ElectronicCats/CatSniffer/hardware/README.md

# Hardware

- Schematic
- PCB Gerbers
- Hardware Libraries
