ElectronicCats/CatSniffer/ataques.md

# Ataques a protocolos IoT

## LoRa/LoRaWAN

- Bit flipping:

## BLE
- Handler enumeration
- List properties
- Flip boolean properties
- Fuzzing handler values

## Zigbee
- https://www.opencve.io/cve?vendor=mi&product=dgnwg03lm

## Thread
- 

## IEEE 802.15.4g,
-

### 6LoWPAN
-
