ElectronicCats/CatSniffer/workshops/BH USA 2023 Arsenal Lab - Catsniffer/BHUS23-Catsniffer.pptx

## Slide 2

Practical IoT Hacking: Introduction to Multi-Band Hacking with the CatSniffer

Eduardo Wero (@foreverwero) / Paulino Calderon (@calderpwn)

## Slide 3

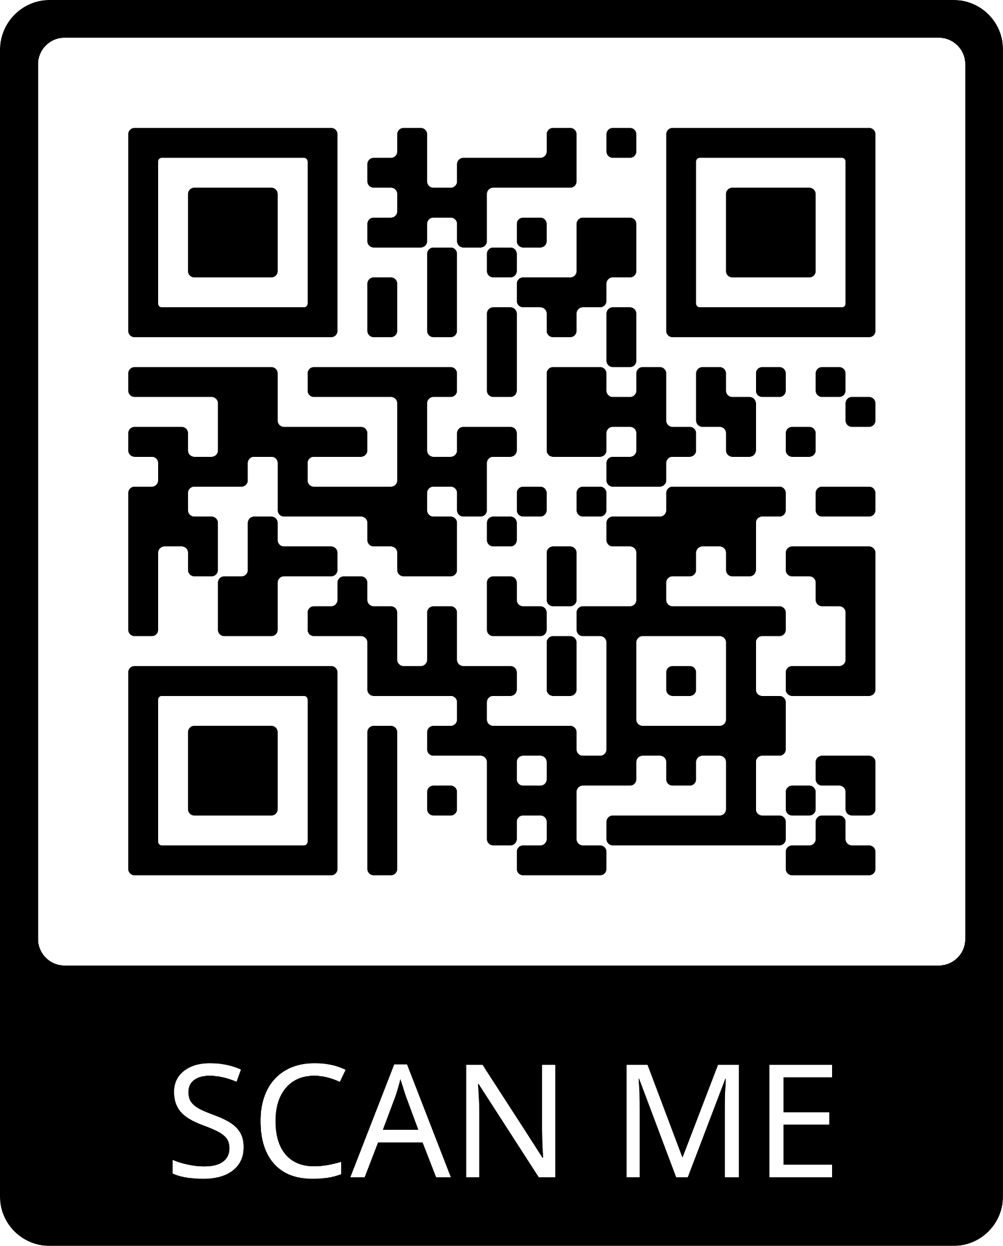
[picture p5: figure]

Workshop resources:

https://bit.ly/3Dsyqol

## Slide 4

CatSniffer

CatSniffer (😼) is an innovative, multi-protocol, multi-band open source circuit board made for sniffing, communicating, and attacking IoT (Internet of Things) devices. It was designed as a highly portable USB stick that integrates TI CC1352, Semtech SX1262, and Microchip SAMD21E17 (V1.x and V2.x)/RP2040 (V3.x).

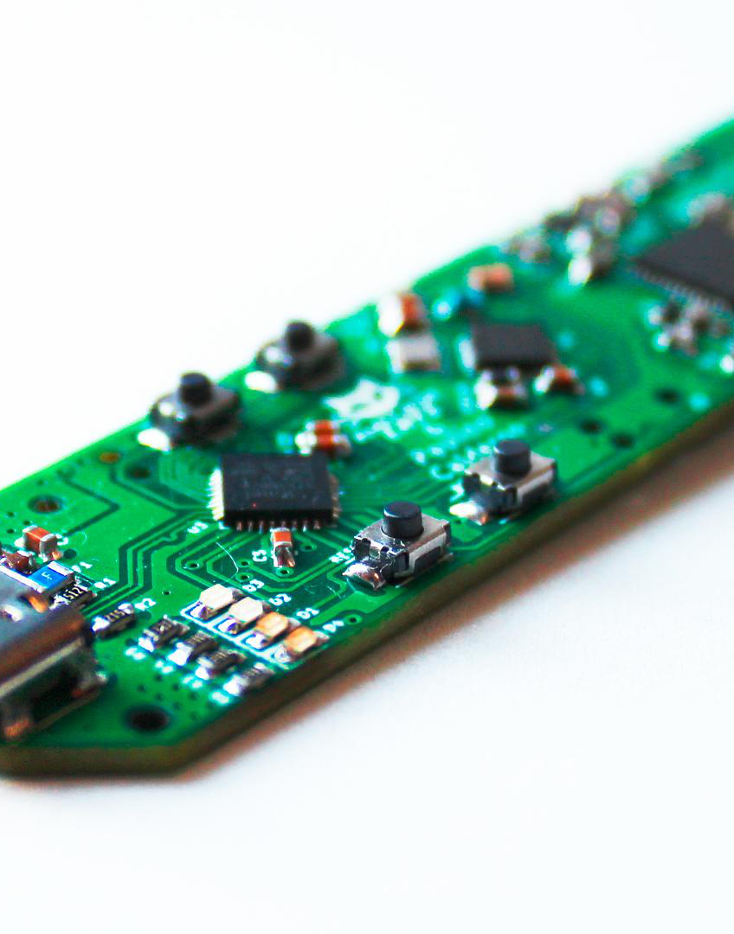
[picture p6: figure]

## Slide 5

## Slide 6

Supported software

This board is a Swiss army knife for IoT security researchers, developers, and enthusiasts. It's highly versatile, compatible with a wide array of software, including:
- Packet Sniffers (*)
- Security auditing tools
- Custom firmware developed by ElectronicCats/PWNLab
(*) It works in Windows with the latest Wireshark!

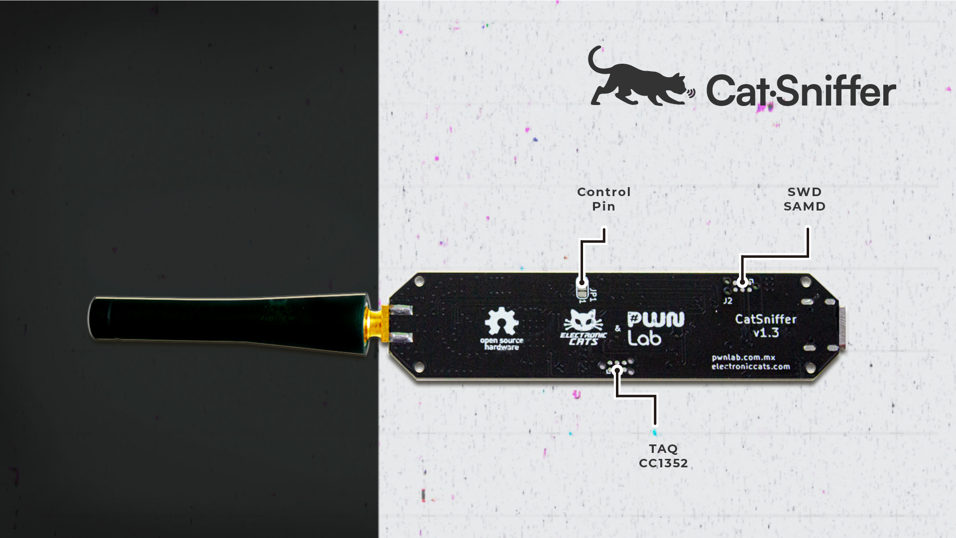
[picture p7: figure]

## Slide 7

Protocols

- Thread
- Zigbee
- Bluetooth 5 Low Energy (BLE)
- IEEE 802.15.4g
- 6LoWPAN (IPv6 over Low power Wireless Personal Area Networks)
- Sub 1Ghz and patented systems
- LoRa/LoRaWAN
Antenna support: 868/915 MHz up to 14 dBm, 2.4 GHz up to 20 dBm

1.x/2.x

- RP2040 microcontroller
- +Wi-SUN
- +Amazon Sidewalk
- +mioty®
Antena support: 433 MHz up to 13 dBm, 2.4 GHz up to 10 dBm

3.x

## Slide 8

SPI

Serial

SX1262

RF Switch

USB

RP2040

CC1352P7

JTAG

GPIOs

## Slide 9

Workshop prerequisites

To challenge yourself and follow along, you will need the following software (*):
- Workshop booklet
https://bit.ly/44yWQsj
- Code Composer Studio from https://www.ti.com/tool/CCSTUDIO
- Code sources from https://github.com/ElectronicCats/CatSniffer/
- Python3 (pyserial and other modules might be needed)
(*) It should be pre-installed in the Kali workstations but USBs with all the files should be available to copy the files to your machines!

## Slide 10

Flashing firmware from Linux

To program your Catsniffer with one of the firmwares available:
1. Locate the desired firmware. You will usually find official firmwares in .hex format.
https://github.com/ElectronicCats/CatSniffer/tree/master/firmware
1. Put the CatSniffer in upload mode for the CC1352P7, press reset for the RP2040 and the boot for the CC1352, then release the reset button and second the boot button, you shall see an animation on the LEDs in the CatSniffer, you are ready to upload the desire firmware to the CC1352.
2. Locate the utility cc2538-bsl.py found in the Code folder.
3. Install the requirements for cc2538-bsl.py by issuing the following commands:
$python3 -m pip install pyserial
$python3 -m pip install intelhex
1. Reset the RP2040 once you have flashed the CC1352P
2. If you would like to read serial information from a terminal, put back the CatSniffer in serial passthrough mode with the correct speed using Arduino IDE. (Optional)

## Slide 11

Practical examples

Follow along with booklet

## Slide 12

Hands on Lab #1: Sniffing BLE

## Slide 13

Learning objectives

1. Flash firmware for sniffing Bluetooth Low Energy connections
2. Basic usage of tools for analyzing BLE traffic
3. Packet structure of different types of BLE packets

## Slide 14

Hands on Lab #2: Detecting personal trackers

## Slide 15

Learning objectives

1. Learn about the technologies used in personal trackers
2. Learn how to detect personal trackers
3. Write custom firmware to detect personal trackers

## Slide 16

Hands on Lab #3: Spoofing personal trackers

## Slide 17

Learning objectives

1. Learn how to spoof personal trackers
2. Learn to craft custom BLE packets
3. Write firmware to communicate with devices over BLE

## Slide 18

Questions?

Eduardo Contreras (e@electroniccats.com)
Paulino Calderon (paulino@pwnlab.mx)
Catsniffer on Github
https://github.com/ElectronicCats/CatSniffer
Download this workshop: https://bit.ly/3Dsyqol
