ElectronicCats/CatSniffer/referencias.md

# Documentos o links de referencia

## Sniffers

- https://github.com/contiki-os/contiki/tree/master/examples/sensniff
- https://openthread.io/guides/pyspinel/sniffer
- https://github.com/andrewdodd/pyCCSniffer
- https://github.com/andrewdodd/ccsniffpiper
- https://github.com/mitshell/CC2531
- https://github.com/nccgroup/Sniffle
- https://hardwear.io/netherlands-2019/presentation/sniffle-talk-hardwear-io-nl-2019.pdf

## Zigbee
- https://github.com/Koenkk/zigbee2mqtt
- https://github.com/Koenkk/Z-Stack-firmware
- apimote http://apimote.com/
- APIMote Schematic https://github.com/riverloopsec/apimote

## Bootloader TI CC1352 

https://www.ti.com/lit/an/swra466c/swra466c.pdf

## CC1352 PINMAP
https://energia.nu/pinmaps/launchxl-cc1352/

## Flash con uniflash
- https://electrolama.com/projects/zig-a-zig-ah/#flashing-using-bsl
- https://github.com/JelmerT/cc2538-bsl
