ElectronicCats/CatSniffer/cases/case-catsniffer-text/front.png

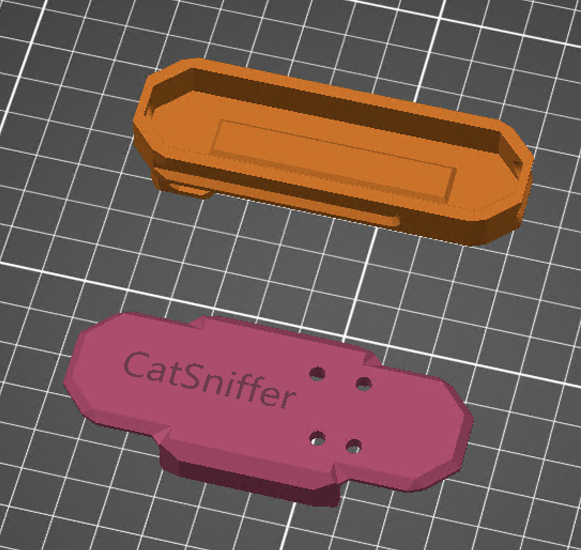
cases/case-catsniffer-text/front.png
