ElectronicCats/CatSniffer/cases/case-catsniffer-text/under.png

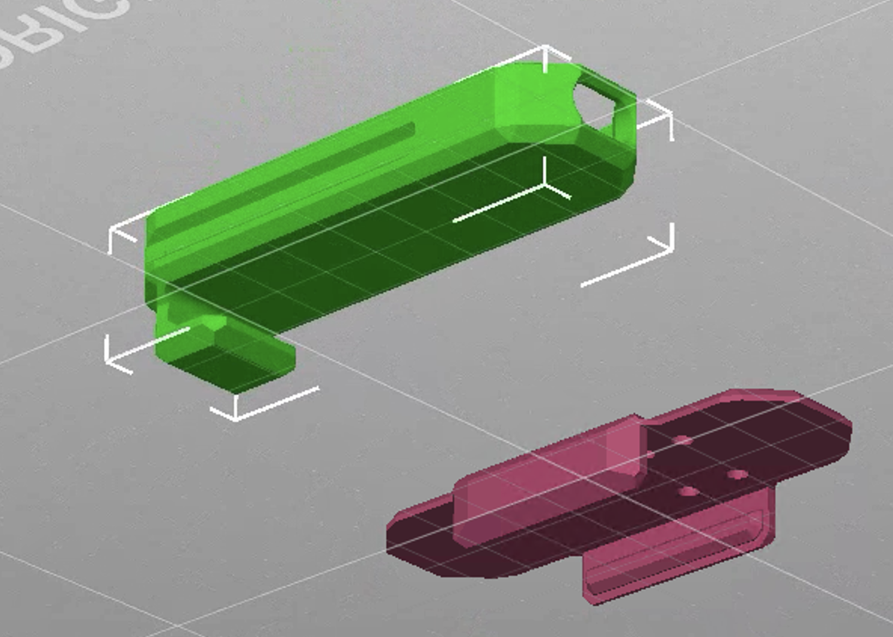
cases/case-catsniffer-text/under.png
