ElectronicCats/CatSniffer/cases/case-mamalon-v1/sc_case.jpg

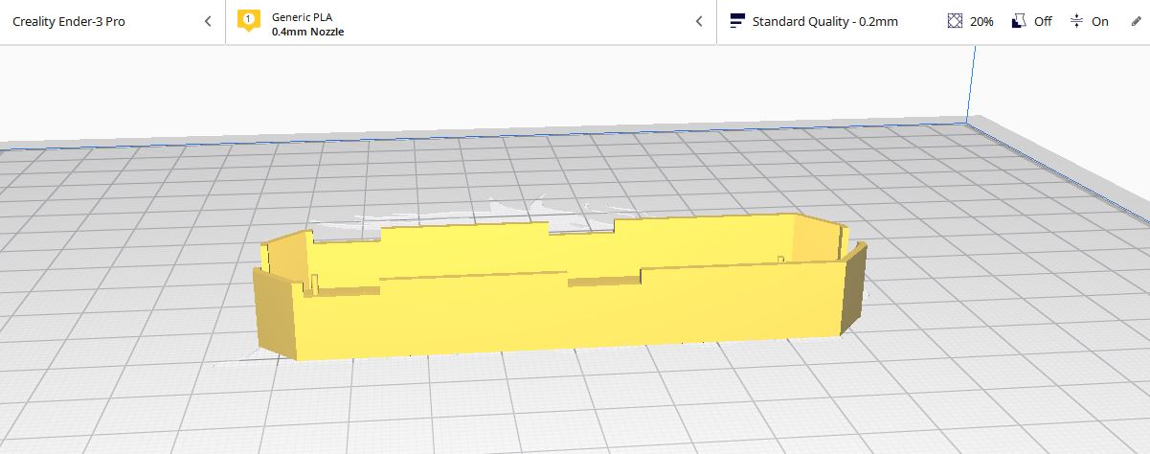
cases/case-mamalon-v1/sc_case.jpg
