ElectronicCats/CatSniffer/cases/case-mamalon-v1/sc_top.jpg

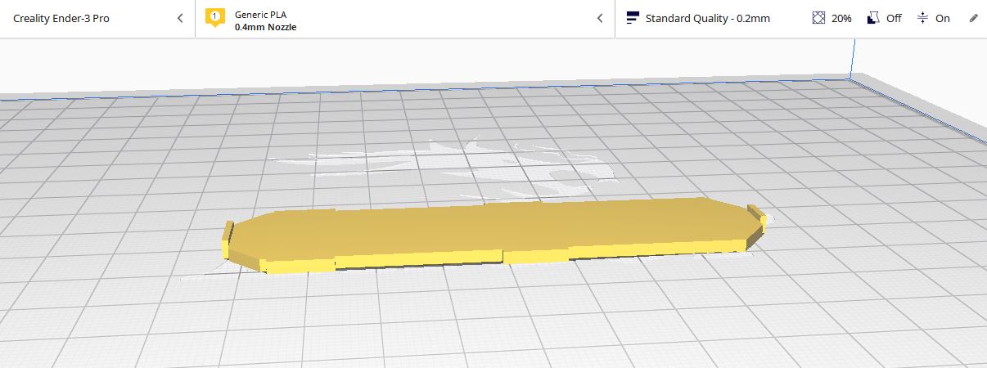
cases/case-mamalon-v1/sc_top.jpg
