ElectronicCats/CatSniffer/cases/basic-case/CatSniffer-case-top.stl

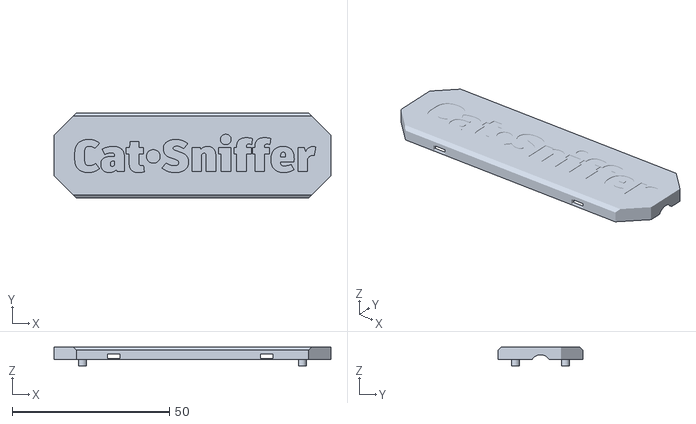
[picture p17: CAD file, 2021-08-19]
cases/basic-case/CatSniffer-case-top.stl
88.2 x 27.2 x 6.00
