ElectronicCats/CatSniffer/cases/case-catsniffer-text/Case-CatSniferText.3mf

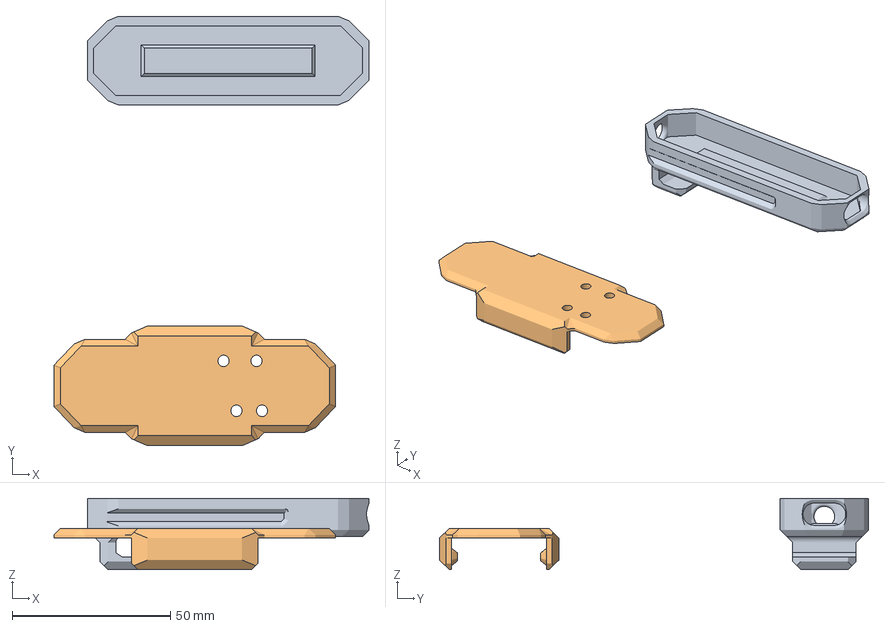
[picture p18: CAD file, 2024-06-25]
cases/case-catsniffer-text/Case-CatSniferText.3mf
99.6 x 135.7 x 22.5 mm
CatSnifer-Base.stl
CatSnifer-Tapa.stl
