ElectronicCats/CatSniffer/cases/case-mamalon-v1/sc_top.stl

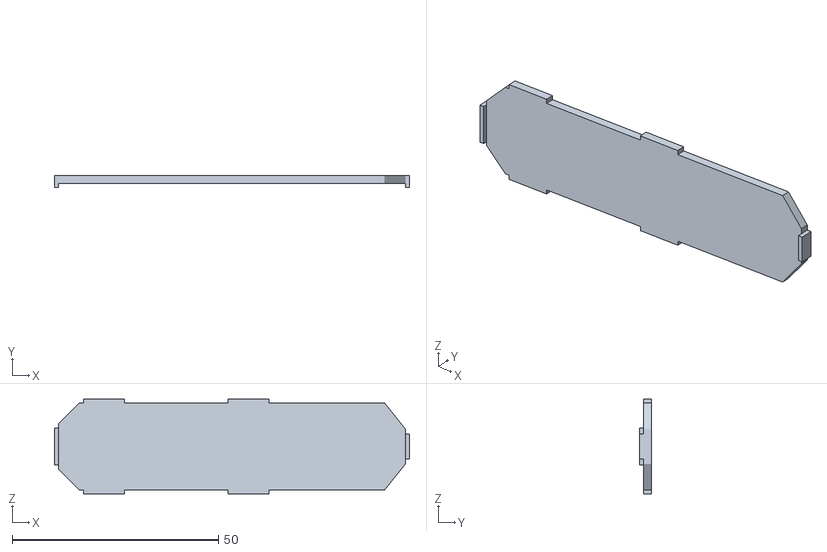
[picture p19: CAD file, 2021-09-11]
cases/case-mamalon-v1/sc_top.stl
86.0 x 3.00 x 23.0
