ElectronicCats/CatSniffer/cases/basic-case/CatSniffer-case-bottom.stl

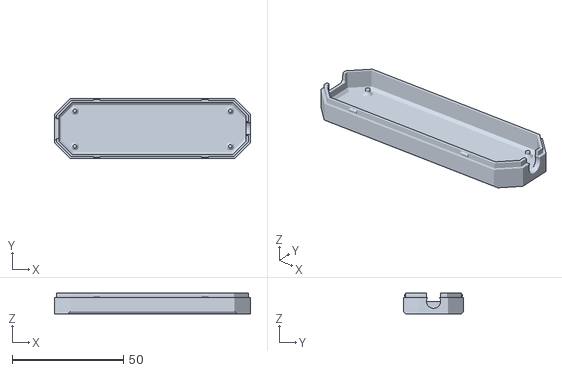
[picture p20: CAD file, 2021-08-19]
cases/basic-case/CatSniffer-case-bottom.stl
88.2 x 27.2 x 9.25
