ElectronicCats/CatSniffer/cases/case-mamalon-v1/sc_case.stl

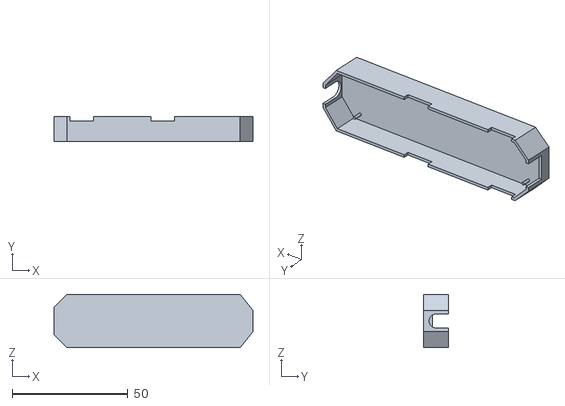
[picture p21: CAD file, 2021-09-11]
cases/case-mamalon-v1/sc_case.stl
86.0 x 11.0 x 23.0
