ElectronicCats/CatSniffer/cases/basic-case/CatSniffer-case.step

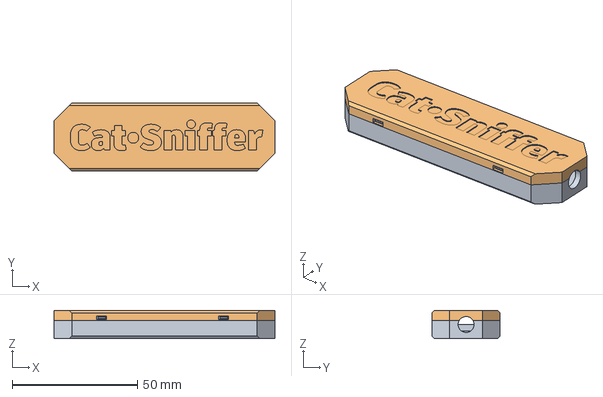
[picture p23: CAD file, 2021-08-19]
cases/basic-case/CatSniffer-case.step
88.2 x 27.2 x 11.2 mm
