ElectronicCats/CatSniffer/(threads)

Thread 18 (2022-01-07):

Wrong image path

Dioscelestial, 2022-01-07:
The part of wireshark.md can't show the images cause' don't have a properly image path in the files
The issues are in ElectronicCats/CatSniffer/docs/wireshark.md

cldrn, 2022-01-08:
Documentation is located at [https://github.com/ElectronicCats/CatSniffer/wiki](https://github.com/ElectronicCats/CatSniffer/wiki) for now. We will be generating an HTML document to include as offline documentation with the repository.

Closed 2022-01-08.

Thread 19 (2022-01-19):

Windows 11 Issue?

Cr0wTom, 2022-01-19:
Hello,

I am trying to setup the SmartRF Packet Sniffer 2 with catsniffer. I can see the serial device in the control panel, but the Device configuration button on SmartRF is grayed out and the device cannot be detected. I had the latest version, but now I am on 1.8.0 of smartRF. I tried many things (I also have the SDK installed) but nothing worked. Anyone solved this issue?

Thanks

wero1414, 2022-01-20:
Hi @Cr0wTom Did you select  the target device under the section of connected devices, to CC1352R?

This is mandatory so the SmartRF Flash Programmer 2 can be able to detect the UART bootloader

wero1414, 2022-01-20:
https://github.com/ElectronicCats/CatSniffer/wiki/assets/foto60.jpg

Arthulisher, 2022-01-20:
Hello Cr0wTom

Please follow the next tutorial:
(https://github.com/ElectronicCats/CatSniffer/wiki/06.-FAQ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)

Let us know any updates about your issue
Best regards...

Cr0wTom, 2022-01-24:
All good, fixed it with firmware reflash a couple of times :)

cldrn, 2022-01-25:
I am curious about what version did you use? Does this confirm Windows 11 support?

Cr0wTom, 2022-01-26:
Yes this confirms Windows 11 support.

I am using Windows 11 Pro (10.0.22000 Build 22000) and my hardware is v1.3.

cldrn, 2022-01-26:
Did you try 1.9 on win 11?

Closed 2022-02-21.

Thread 21 (2022-02-18):

Failed to flash a new firmware.

icabrera, 2022-02-18:
Hello,

I am trying to change the firmware of the CC1352.

I have succesfully loaded the sketch "Serial Passthrought with Bootloader" into the CatSniffer.

Also, I did the procedure to enter into bootloader by power off -- pressing boot button -- and then power on again. It didn't work and no LED activity.

I have noticed that CC1352 continues sending a message by UART (received by the serial passthorugh with boot) after it is supposed to be in a bootloader mode, so I think that CC1352 doesn't enter into bootloader.

The following is the received message, this is the same as when the Sniffer Firmware is working:

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

Note: I changed the baudrate in the bootloader sketch just to be sure that CC1352 is sending the same announcement, but also tried with 500000. Changed to 500000, the message is also arriving but it is not readable:

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

I have been trying since I received the CatSniffer but never been acomplished. I have tried with TI and Python tools but since CatSniffer is not in bootloader mode that tools doesn't work.

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

According to the CC13x2, CC26x2 SimpleLink Wireless MCU Technical Reference Manual, the baudrate of UART for bootloader can be synchoronized by sending 0x55 0x55.  The answer to this bytes, are the same, the announcement message.

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

The CatSniffer is working well with the stock firmware.

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

icabrera, 2022-02-21:
Yes, I tried both ways ( button and by sketch ), and also tried a mix of two, no success.

sabas1080, 2022-02-21:
@icabrera This product will be replaced under warranty.

defuzzlog, 2022-03-04:
Hi. I have the same situation. Catsniffer isn't recognised in the Smart RF Sniffer 1.9 (already checked FAQ wiki github page - still no result). When I try to change firmware of the 1352 - nothnig happens. I can upload Serial Passthrought with bootloader, but
Flash Programmer 2 doesn't see device and when I try to flash with python I get error " Timeout waiting for ACK/NACK after 'Synch (0x55 0x55)". Also when I try to enter bootloader through hardware  first pressing the “boot” button and while holding it, press and release "reset", and finally release the “boot” button - nothing happens, it didn't work and No LED activity.  Tried to run on three different computers, used different usb cables - nothing helps.

Closed 2022-02-21.

Thread 22 (2022-03-05):

Can't flash CC1352

defuzzlog, 2022-03-05:
Hi.
Catsniffer isn't recognized in the Smart RF Sniffer 1.9 (already read and applied advice from FAQ wiki GitHub page - still no result). When I try to flash the firmware of the 1352 - nothing happens. I can upload "Serial Passthrough with bootloader", but
Flash Programmer 2 doesn't see the device and when I try to flash with python I get the error " Timeout waiting for ACK/NACK after 'Synch (0x55 0x55)". Also when I try to enter the bootloader through hardware first press the “boot” button and while holding it, press and release "reset", and finally release the “boot” button - nothing happens, it didn't work and No LED activity. Tried to run on three different computers, used different USB cables - nothing helps.

defuzzlog, 2022-03-13:
Is there any other way I can help to solve this problem? Maybe some additional data or logs are needed? And should I hope for a solution to this problem? Thanks

sabas1080, 2022-03-13:
@defuzzlog CatSniffer is not compatible with version 1.9 of Smart RF Sniffer, you must use version 1.8 as indicated in our wiki.

when cat sniffer is in boot mode, there is no LED activity.

To ensure that the device is in boot mode press the BOOT button without connecting to the computer, keep the BOOT button pressed and then connect the device via USB, now release the BOOT button

defuzzlog, 2022-03-13:
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

Just checked in Smart RF Packet Sniffer 1.8 - it is doesn't detect Catsniffer.

Folowed you steps - press Boot and hold it until device connected via USB, release it after connection via usb. Doesn't help. It still can't find cc1352 over python cmd or flash programmer

defuzzlog, 2022-03-14:
> Hello @defuzzlog Could you share pictures of your COM port on the device manager? in order to see if your system is detecting your board.

Without catsniffer: [https://disk.yandex.ru/i/Fq3Yyq3xIx76dw](url)
With catsniffer: [https://disk.yandex.ru/i/Zy41JxDXJknXYQ](url)

Arthulisher, 2022-03-23:
Hello, @defuzzlog Could you describe or share a video of the Led 4 behavior when you plug the USB, Please? Also, could you upload to the cat sniffer the serial passthrough and describe the behavior too?

defuzzlog, 2022-03-29:
> Hello, @defuzzlog Could you describe or share a video of the Led 4 behavior when you plug the USB, Please? Also, could you upload to the cat sniffer the serial passthrough and describe the behavior too?

[https://youtu.be/QrYOePBE02g](url)

Arthulisher, 2022-03-29:
Hello @defuzzlog  thanks for the video, could you upload the SerialPassthrough.ino please and describe the behavior of LED D4, please?

Arthulisher, 2022-03-31:
Hello @defuzzlog

It seems to be that your CC1352 chips are bricked, could you send us an e-mail at the next address support2@electroniccats.com, please?
We are going to continue your issue by e-mail.

alphafox02, 2023-08-15:
Was this ever resolved, if so how was the CC1352 flashed?

Closed 2022-04-05.

Thread 25 (2022-06-26):

CC1352 and LoRa compatibility

reiniercoetzer, 2022-06-26:
Hi Electronic Cats (@Liars126) !

I recently came across your CatSniffer, which is a pretty handy device!

I am currently doing some research on LoRa compatible MCUs and officially it seems as though TI does not support LoRa. However, I also read that the CC1352 (which you guys are using) supports Amazon Sidewalk, which is based on LoRa (perhaps only the protocol?).

For the CatSniffer, I assume you use the Semtech SX1262 for LoRa, but since you are also familiar with the CC1352, do you perhaps know if this MCU is somehow compatible with the LoRa PHY?

Thanks in advance!

Best regards,
  Reinier

jazhe, 2022-07-01:
Hello @reiniercoetzer!

Thank you for the interest in our products and your feedback, is much appreciated!

Yes, we use Semtech SX1262 for LoRa and unfortunately CC1352 is not compatible with LoRa.

Thank you for you patience. Feel free to get back to us if you have any further queries.

Kind regards,
Electronic Cats Support Team

reiniercoetzer, 2022-07-07:
Many thanks for your feedback!

Maybe useful for someone else in the future (you guys know this of course):

I also got some information directly from TI and as expected the CC1352 PHY is not compatible with the standard LoRa modulation, i.e. LoRa uses chirp spread spectrum (CSS) technology, whereas the CC1352 PHY can do spread spectrum using GFSK, which is more applicable to Amazon Sidewalk for which the CC1352 is supported.

jazhe, 2022-07-07:
Hi @reiniercoetzer!

Thank you so much for your feedback, we appreciate it!

We are very grateful that you bring this to our attention. These types of feedback help us improve our platform and our products! Feel free to get back to us if you have any further queries or feedback.

Hope you have an amazing day!
Kind regards,
Electronic Cats Support Team

Closed 2022-07-06.

Thread 26 (2022-08-17):

Missing documentation

iamapentester, 2022-08-17:
This project is really hard to get started with.

The github contains a lot of firmwares and 3d Prints files but not really any informations of how to install the firmware and use the stick.

Could you make a quick-start guide - i am running Linux and bought this stick because it was linux compatible but have still not figured out how to get it up and running - wireshark plugins is only for windows :/

IvanAmg, 2022-08-17:
Hello @iamapentester!
Have you already visited our official Wiki?
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
There you'll find our quickstart guide.
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
Let me know if something else is missing!

iamapentester, 2022-08-18:
ah ! pages .. i missed them - thanks.

IvanAmg, 2022-08-18:
No worries at all!

Closed 2022-08-18.

Thread 27 (2022-08-22):

SmartRF can't detect CatSniffer

gilmarwsr, 2022-08-22:
SmartRF can't detect CatSniffer, is there any troubleshoot script? How can I check if the hardware (bought at DEFCON30) is fine?

I've tried some firmware scripts just to check the communication:
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

I've changed the timeout on the python script :

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

I'm switched from MacOS to an  Windows 8 on Parallels ... and the drivers seems to haven't been installed:
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

IvanAmg, 2022-08-23:
Hello @gilmarwsr !
May I ask if the LED4 is blinking when connected to your PC?
If so, please try to enter on bootloader mode.
To enter this mode, first press the “boot” button, and while holding it, press and release "reset", and finally release the “boot” button.
LED4 should now stop blinking.
Now you should be able to connect your board.
However, please let me know if the issue persists!

gilmarwsr, 2022-08-23:
> Hello @gilmarwsr !
> May I ask if the LED4 is blinking when connected to your PC?
Yes It is.

> If so, please try to enter on bootloader mode.
> To enter this mode, first press the “boot” button, and while holding it, press and release "reset", and finally release the “boot” button.
> LED4 should now stop blinking.
The LED4 stopped to blink so all LEDs are now off.

> Now you should be able to connect your board.
> However, please let me know if the issue persists!
Unfortunately the problem persists.

IvanAmg, 2022-08-24:
The CatSniffer has a similar chip as our DAPCat.
Please, try installing this driver https://zadig.akeo.ie/ if using windows 8.
And using MacOS, please specify your port when running the python script.
Let me know if the issue persists!

gilmarwsr, 2022-08-25:
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

I tried my best to install multiple drivers, change COM ports and etc... now, my CatSniffer LED4 is blinking and this two drivers are listed:
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

But, the SmartRF (v 1.8.0) still can't detect the CatSniffer...

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

IvanAmg, 2022-08-25:
Thanks a lot for all the information!
Let's try troubleshooting with the python script, as this is the easiest way to get more information about the issue.

First, please try to upload the SerialPassThroug with bootloader.ino as this guide says https://github.com/ElectronicCats/CatSniffer/wiki/02.-Flashing-firmwares-(Bootloader-Modes-and-Software)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,Bootloader%20mode%20through%20firmware,-To%20enter%20in

Then, try to enter bootloader mode.
To enter this mode, first press the “boot” button, and while holding it, press and release "reset", and finally release the “boot” button. LED4 should stop blinking by now.

After that, please, use the python cc2538-bsl.py -p "port" command on your terminal, where "port" is the port number of where the CatSniffer is connected to your PC, this may change depending on your OS.

Let me know if the issue persists!

gilmarwsr, 2022-08-26:
@IvanAmg

I've tried to upload via python:
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

I also tried via SmartRF Flash Programmer 2 (ver 1.8.2)

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

To be clear, in this SmartRF Flash section its an item (item 2)
> 2. Upload the firmware SerialPassThroughwithboot.ino to your CatSniffer.

I really don't understand if this is an instruction to me to upload the file to somewhere (how?) or this is what we gonna do now... (I'm Brazilian so English is not my first language).

IvanAmg, 2022-08-26:
@gilmarwsr In order to upload the SerialPassThroughwithboot.ino to your CatSniffer, you may need to use the Arduino IDE.
To install our board cores and support, please follow this part of the wiki.
https://github.com/ElectronicCats/CatSniffer/wiki/02.-Flashing-firmwares-(Bootloader-Modes-and-Software)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,Arduino%20IDE%20and%20Electronic%20Cats%20Board%20Support,-The%20Arduino%20Integrated
This .ino file is available right here.
https://github.com/ElectronicCats/CatSniffer/tree/master/firmware/SAMD/SerialPassthroughwithboot
Please, use the Arduino IDE to upload the SerialPassthroughwithboot.ino, and try to connect again with the python script.
Let me know if the issue persists!

gilmarwsr, 2022-08-26:
@IvanAmg
I've uploaded SerialPassThroughwithboot.ino

Sketch uses 9432 bytes (3%) of program storage space. Maximum is 262144 bytes.
Global variables use 2124 bytes of dynamic memory.
Atmel SMART device 0x10010094 found
Device       : ATSAMD21E17D
Chip ID      : 10010094
Version      : v1.1 [Arduino:XYZ] Jul 24 2021 11:48:53
Address      : 8192
Pages        : 1920
Page Size    : 64 bytes
Total Size   : 120KB
Planes       : 1
Lock Regions : 16
Locked       : none
Security     : false
Boot Flash   : true
BOD          : true
BOR          : true
Arduino      : FAST_CHIP_ERASE
Arduino      : FAST_MULTI_PAGE_WRITE
Arduino      : CAN_CHECKSUM_MEMORY_BUFFER
Erase flash
done in 0.577 seconds

Write 9784 bytes to flash (153 pages)
[==============================] 100% (153/153 pages)
done in 0.087 seconds

Verify 9784 bytes of flash with checksum.
Verify successful
done in 0.032 seconds
CPU reset.

But the python script ,or  SmartRF Flash Programmer 2, doesn't work.
Now, when I connect my board all LEDs are off, which I think its okay, right?
I can reset the CS1352P by press the reset button (and the LED4 starts to blink).
I've tried python script on boot settings (all LEDs off).

IvanAmg, 2022-08-29:
Hi! @gilmarwsr
Let's try a different thing.
On the [SerialPassthrough.ino](https://github.com/ElectronicCats/CatSniffer/blob/master/firmware/SAMD/SerialPassthrough/SerialPassthrough.ino) example, you'll see these baud rate code lines.
```
//unsigned long baud = 921600;//Baud for SmartRF Sniffer 2 also works with Smart RF Flash Programmer 2
unsigned long baud = 2000000;//Baud for Sniffle
//unsigned long baud = 115200;//Baud for Zigbee2MQTT
```
Please, comment the baud for sniffle and erase the // from Baud for SmartRF. Should look something like this.
```
unsigned long baud = 921600;//Baud for SmartRF Sniffer 2 also works with Smart RF Flash Programmer 2
//unsigned long baud = 2000000;//Baud for Sniffle
//unsigned long baud = 115200;//Baud for Zigbee2MQTT
```
Upload it to your board with Arduino IDE.
After that please, try to connect it again with SmartRF.
If the issue persists, please try the python script with your Mac OS pc, as the compatibility with Windows 8 is not fully tested yet.
Make sure that the command specifies the COM where you're connecting your CatSniffer to your Mac.

gilmarwsr, 2022-09-01:
@IvanAmg
Let me update the whole situation...
I was able to use the python script (only in MacOs), unfortunately, it seems to be a problem with windows 8 compatibility. I will try SmartRF as soon as possible with a fresh Windows 10 installation.
Is there any chances to use Wireshark on MacOS with CatSniffer?

IvanAmg, 2022-09-02:
@gilmarwsr
I'm glad that it is working now!
We'll include that compatibility issue in our wiki, thanks for letting us know about it.
There's a small guide about Wireshark using windows, it seems like Mac OS hasn't been tested yet, if you would like to try and share your results with us, that would be amazing!

Closed 2022-09-02.

Thread 46 (2023-08-15):

Feedback (CatSniffer v2)

alphafox02, 2023-08-15:
Received a CatSniffer over the weekend and wanted to share some notes while they're fresh.

Found my way to here after finding mention in another closed ticket
https://github.com/ElectronicCats/CatSniffer/wiki/02.-Flashing-firmwares-(CatSniffer-v1.x-and-2.x)

Attempted to get to bootloader mode on the CC1352 using the hardware method and 22.04, but after making double sure I was pushing the right button combo I always ended up getting back to one flashing light and the following (mentioned in another closed ticket)
```
Opening port /dev/ttyACM0, baud 500000
Connecting to target...
ERROR: Timeout waiting for ACK/NACK after 'Synch (0x55 0x55)'
```

I then grabbed the Arduino IDE and followed the software steps, uploaded the sketch that I finally found here (wiki doesn't say exactly where to find it)
https://github.com/ElectronicCats/CatSniffer/tree/master/firmware/V1.x_V2.x/SAMD21E17/SerialPassthroughwithboot

At which point I was able to perform the following, while not certain of the firmware version as it doesn't match what the wiki says

`python3 cc2538-bsl.py -e -w -v -p /dev/ttyACM0 /home/dragon/Downloads/CatSniffer/firmware/V1.x_V2.x/CC1352P2/TI_PACKET_SNIFFER/sniffer_fw/bin/cc1352p1lp/sniffer_fw.hex`

The one blue light blinks, but what I notice is that after unplugging and plugging back in no lights blink and it's essentially needing me to reflash the hex file.

pycatsniffer.py seems to run, but there's no results.

Is there a newer/more clear set of steps to follow when going from brand new to operation? There was one light blinking on it when I took it out of the bag, but pycatsniffer.py did not seem to work and would just hang. Surely I'm missing something here.

alphafox02, 2023-08-15:
Most likely now a mistake on my part, but I tried the cc1352r1lp/sniffer_fw.hex file to see if there was a difference and now I'm unable to reflash anything even after uploading the sketch.

Eric286, 2023-08-15:
Hello @alphafox02 !

Sorry to hear you're having trouble with your CatSniffer. In order to help you more effectively, I would need a few additional details.

Firstly, could you share a photograph of both sides of the catSniffer please, to verify the version you have.

What operating system are you using? For example, Windows, macOS, or Linux.

You mentioned that some lights blink at certain times, while at other times they don't. Could you describe in detail what the status of the lights is at different times (at power on, when trying to load firmware, etc.)?

Any error messages you may have received, such as the one you mentioned: "ERROR: Timeout waiting for ACK/NACK after 'Synch (0x55 0x55)'". These details will help us better understand the problem.

I also saw that you sent us an email, please let me know if you would like to receive support via Github or if you prefer to receive support via email.

Have a good day!

alphafox02, 2023-08-16:
I can send pics via email if you reach out and follow up as needed (it states v2.0 on both sides), thought maybe details here will help someone else.

I'm using Linux, 22.04 to be specific. When I very first received the device there was the one light blinking when plugged in, however as I mentioned above the pycatsniffer did not function properly.

So I attempted to follow the wiki, the button combo to get into bootloader mode would not work for me. I had to move to the other method, which worked. I was able to load the cc1352p1lp/sniffer_fw.hex file. Unplugging and plugging the catsniffer back in would result in the one light blinking and the pycatsniffer would at least not freeze up when starting/stopping and existing but I still seemed to get no results.

So I ended up flashing the other firmware against my better judgement, cc1352r1lp/sniffer_fw.hex.

Now when i unplug and plug back in the sniffer no lights are lit at all. If I run through uploading the sketch a file links blink on it until it's done, at which point no lights are blinking. It's like it's in bootloader mode, but it's locked or something as I can no longer flash a .hex file without it ending in the ACK/NACK error. That's the only error I have.

Before flashing with the cc135r1lp hex file I could put it in bootloader mode over and over without issue and reflash the cc1352p1lp as many times as I wanted.

Eric286, 2023-08-16:
Hello @alphafox02

Thank you for the information and yes please send me the photographs by mail.

Also to unbrick the CC135, you would have to follow these steps.

In order to restore the CC1352 firmware from brick, you'll need a J-Link or any similar programmer.
This guide will explain how to recover from a brick state using a J-Link programmer.

Download and install J-link software: https://www.segger.com/downloads/jlink/
Connect your CatSniffer using the correct connector. If the JTAG connector is not available, using jumper cables may be a solution.
Make sure that each pin is connected properly with the SWD pinout (programmer and CatSniffer).
Open J-Flash Lite.
Download the firmware file: https://github.com/ElectronicCats/CatSniffer/tree/master/firmware/TI_PACKET_SNIFFER/sniffer_fw/bin

IMPORTANT
Make sure which chip your CatSniffer includes.
The steps shown in this guide explain how to restore a CC1352P1F3 chip.
Select this chip on J-Link Software, and upload the corresponding .hex file.
Finally, press the Program Device button.
The LED 4 blink will tell you if the programming was successful.

Kind Regards!

alphafox02, 2023-08-16:
Looking at the cost on some of these J-Link programmers has me a little concerned. I’ll have to do some research there and see if some of the cheaper solutions do in fact work with the J Link Software.

Separately, you mention a guide and to connect to the correct pins. I went and had another look at the CatSniffer and there is no “pins” per se sticking up to attach you. Do you have a picture/guide somewhere that shows this type of connection setup?

Thank you.

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

Eric286, 2023-08-16:
Hello @alphafox02

There is also a cheaper option called the J-Link EDU

The pins are the ones below the label that says pwm lab.

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

In this section of the wiki, you can see more information and see how they connect to the j pins.

https://github.com/ElectronicCats/CatSniffer/wiki/08.-Restore-the-CC1352-firmware

You could use a Raspberry Pico if you wanted to and solder to the programming pins.

Kind Regards!

Support Team.

alphafox02, 2023-08-16:
Excellent and yes, I should’ve looked just a little further down on the wiki! I guess I wasn’t totally sure what was up, but now I’ll work on getting those items and it restored asap.

alphafox02, 2023-08-18:
Thank you. I’ve put an order in for parts to get it back up and going. I’ll follow up once complete.

Eric286, 2023-08-18:
Hello @alphafox02

If you'd like, we can close the GitHub issue for now, and when you have the parts, we can reopen it. Alternatively, if you prefer, we can keep the GitHub issue open.

Kind Regards!

Support Team.

alphafox02, 2023-08-25:
Word of advice for anyone having a similar issue. The J-Link EDU mini and the TC2030 plug of nails cable are not going together by default. The mini is tiny and has pins far closer together than the TC2030 connector. I couldn’t tell how small the mini was till it arrived.

Eric286, 2023-08-25:
Hello @alphafox02

Eric286, 2023-08-25:
Hello @alphafox02

Thank you for sharing the word of advice about the compatibility between the J-Link EDU mini and the TC2030 plug of nails cable. Your input will certainly be valuable to others who might face a similar issue.

If you encounter any further difficulties or wish to share any feedback, please feel free to reach out to us again. We are here to assist you.
Wishing you a fantastic day ahead!

Kind regards,

Electronic Cats Support Team.

alphafox02, 2023-08-26:
Reading over this link here is basically where I'm at too. I've purchased the programmer, cable, and went and found a 10 pin to six pin. I've followed the steps listed on the wiki in section 8, have the software downloaded and can run the J-Flash Lite but with cjtag settings I can see one light flash when hitting erase and program on the GUI.. but it always says also Error could not connect to target.

I don't know if I want to invest more time/money into getting this back working. Seems like a nice device though.

Eric286, 2023-08-29:
Hello @alphafox02

Could you send me a video of the process in addition to the invoice of your purchase to this email please.

support4@electroniccats.org

Best regards!

alphafox02, 2023-08-30:
Soon as I get home I sure will. I’ll close this out and contact via email. I think if we get it flashed back and working I’ll just come back and update this with the details.

alphafox02, 2023-10-02:
Package arrived today! Got it plugged in and haven’t had a lot of time to test but I did try the default python script provided and attempted into Wireshark. I see a lot of output python side but nothing Wireshark side yet. I’ll test with known ble tx asap.Thank you very much for all the help! I can’t wait to make some videos on its usage. Sent from my iPhoneOn Aug 29, 2023, at 4:03 PM, Eric Chavez ***@***.***> wrote:
Hello @alphafox02
Could you send me a video of the process in addition to the invoice of your purchase to this email please.
***@***.***
Best regards!

—Reply to this email directly, view it on GitHub, or unsubscribe.You are receiving this because you were mentioned.Message ID: ***@***.***>

alphafox02, 2023-10-03:
Also tried to flash the sniffle binary via uniflash and python script but it’s unclear if I need to put it into bootloader mode. I tried with holding reset 1 and boot 1 and releasing reset 1. But only blue light comes back on and flashes, nothing else.How are you all loading the .our file for 1.6 sniffle on the v.3.x CatSniffer? It seems that currently in Linux only snuffle and potentially the ble info into Wireshark may work? Sent from my iPhoneOn Oct 2, 2023, at 7:05 PM, Alpha Fox ***@***.***> wrote: Package arrived today! Got it plugged in and haven’t had a lot of time to test but I did try the default python script provided and attempted into Wireshark. I see a lot of output python side but nothing Wireshark side yet. I’ll test with known ble tx asap.Thank you very much for all the help! I can’t wait to make some videos on its usage. <image0.jpeg>Sent from my iPhoneOn Aug 29, 2023, at 4:03 PM, Eric Chavez ***@***.***> wrote:
Hello @alphafox02
Could you send me a video of the process in addition to the invoice of your purchase to this email please.
***@***.***
Best regards!

—Reply to this email directly, view it on GitHub, or unsubscribe.You are receiving this because you were mentioned.Message ID: ***@***.***>

Eric286, 2023-10-03:
Hello @alphafox02

Please first upload the uf2 file called SerialPassthroughwithboot.

https://github.com/ElectronicCats/CatSniffer/tree/master/firmware/V3.x/RP2040/SerialPassthroughwithboot

Press the reset button twice and drag the uf2 file to the file explorer.

After uploading the file, reset the board.

Then put the CC1352 in bootloader mode.
    Press and hold the "reset_CC1" button.
    While still holding the "reset_CC1" button, press and hold the "BOOT1" button.
    Release the "reset_CC1" button first.
    Release the "BOOT1" button.

After this please try the python steps again.

Have a nice day!

Support Team.

alphafox02, 2023-10-04:
Tried as I believe you’re describing, assuming you mean to run and attempt to install sniffle after in bootloader mode. See picture. What I’m also not understanding is what is the tool pyCatSniffer designed for? Is there anything linux related that can run with the CatSniffer in the state it’s delivered in?Sent from my iPhoneOn Oct 3, 2023, at 12:15 PM, Eric Chavez ***@***.***> wrote:
Hello @alphafox02
Please first upload the uf2 file called SerialPassthroughwithboot.
https://github.com/ElectronicCats/CatSniffer/tree/master/firmware/V3.x/RP2040/SerialPassthroughwithboot
Press the reset button twice and drag the uf2 file to the file explorer.
After uploading the file, reset the board.
Then put the CC1352 in bootloader mode.
Press and hold the "reset_CC1" button.
While still holding the "reset_CC1" button, press and hold the "BOOT1" button.
Release the "reset_CC1" button first.
Release the "BOOT1" button.
After this please try the python steps again.
Have a nice day!
Support Team.

—Reply to this email directly, view it on GitHub, or unsubscribe.You are receiving this because you were mentioned.Message ID: ***@***.***>

alphafox02, 2023-10-04:
I also tried the following, never finishes and when I unplug and plug back in the CatSniffer it’s flashing two blue lights Sent from my iPhoneOn Oct 3, 2023, at 8:39 PM, Alpha Fox ***@***.***> wrote: Tried as I believe you’re describing, assuming you mean to run and attempt to install sniffle after in bootloader mode. See picture. What I’m also not understanding is what is the tool pyCatSniffer designed for? Is there anything linux related that can run with the CatSniffer in the state it’s delivered in?<image0.jpeg>Sent from my iPhoneOn Oct 3, 2023, at 12:15 PM, Eric Chavez ***@***.***> wrote:
Hello @alphafox02
Please first upload the uf2 file called SerialPassthroughwithboot.
https://github.com/ElectronicCats/CatSniffer/tree/master/firmware/V3.x/RP2040/SerialPassthroughwithboot
Press the reset button twice and drag the uf2 file to the file explorer.
After uploading the file, reset the board.
Then put the CC1352 in bootloader mode.
Press and hold the "reset_CC1" button.
While still holding the "reset_CC1" button, press and hold the "BOOT1" button.
Release the "reset_CC1" button first.
Release the "BOOT1" button.
After this please try the python steps again.
Have a nice day!
Support Team.

—Reply to this email directly, view it on GitHub, or unsubscribe.You are receiving this because you were mentioned.Message ID: ***@***.***>

alphafox02, 2023-10-04:
Well in this case I was using the wrong directory/firmware.. I’ll try again with v3 Sent from my iPhoneOn Oct 3, 2023, at 8:46 PM, Alpha Fox ***@***.***> wrote: I also tried the following, never finishes and when I unplug and plug back in the CatSniffer it’s flashing two blue lights <image0.jpeg>Sent from my iPhoneOn Oct 3, 2023, at 8:39 PM, Alpha Fox ***@***.***> wrote: Tried as I believe you’re describing, assuming you mean to run and attempt to install sniffle after in bootloader mode. See picture. What I’m also not understanding is what is the tool pyCatSniffer designed for? Is there anything linux related that can run with the CatSniffer in the state it’s delivered in?<image0.jpeg>Sent from my iPhoneOn Oct 3, 2023, at 12:15 PM, Eric Chavez ***@***.***> wrote:
Hello @alphafox02
Please first upload the uf2 file called SerialPassthroughwithboot.
https://github.com/ElectronicCats/CatSniffer/tree/master/firmware/V3.x/RP2040/SerialPassthroughwithboot
Press the reset button twice and drag the uf2 file to the file explorer.
After uploading the file, reset the board.
Then put the CC1352 in bootloader mode.
Press and hold the "reset_CC1" button.
While still holding the "reset_CC1" button, press and hold the "BOOT1" button.
Release the "reset_CC1" button first.
Release the "BOOT1" button.
After this please try the python steps again.
Have a nice day!
Support Team.

—Reply to this email directly, view it on GitHub, or unsubscribe.You are receiving this because you were mentioned.Message ID: ***@***.***>

alphafox02, 2023-10-04:
I made a small video and have tried several ways so far. Always ends in Synch (0x55 0x55) and each time I plug in CatSniffer it’ll have the outer two blue lights flashing in sync as if it’s just waiting for me to run the method to put it in  bootloader mode. CatSniffer - Google Drivedrive.google.comSent from my iPhoneOn Oct 3, 2023, at 8:39 PM, Alpha Fox ***@***.***> wrote: Tried as I believe you’re describing, assuming you mean to run and attempt to install sniffle after in bootloader mode. See picture. What I’m also not understanding is what is the tool pyCatSniffer designed for? Is there anything linux related that can run with the CatSniffer in the state it’s delivered in?<image0.jpeg>Sent from my iPhoneOn Oct 3, 2023, at 12:15 PM, Eric Chavez ***@***.***> wrote:
Hello @alphafox02
Please first upload the uf2 file called SerialPassthroughwithboot.
https://github.com/ElectronicCats/CatSniffer/tree/master/firmware/V3.x/RP2040/SerialPassthroughwithboot
Press the reset button twice and drag the uf2 file to the file explorer.
After uploading the file, reset the board.
Then put the CC1352 in bootloader mode.
Press and hold the "reset_CC1" button.
While still holding the "reset_CC1" button, press and hold the "BOOT1" button.
Release the "reset_CC1" button first.
Release the "BOOT1" button.
After this please try the python steps again.
Have a nice day!
Support Team.

—Reply to this email directly, view it on GitHub, or unsubscribe.You are receiving this because you were mentioned.Message ID: ***@***.***>

Eric286, 2023-10-04:
Hello @alphafox02.

Please follow these steps to restore the Catsniffer, then follow the steps I mentioned above, this resolves the error 0x55 0x55

https://github.com/ElectronicCats/CatSniffer/wiki/08.-Restore-the-CC1352-firmware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

Best Regards!

alphafox02, 2023-10-12:
Just noticing this, I'm slightly confused with the directions as it looks
like I'd need to set up windows and follow all steps, not sure the rp2040.
However, I think my catsniffer is probably fine because I do not think I
ever got into boot mode to begin with to have changed the firmware at all.

If you still suggest I follow the guide above I can find a windows
computer, but my time may be better spent trying to do a video call as soon
as possible.

On Wed, Oct 4, 2023 at 11:49 AM Eric Chavez ***@***.***>
wrote:

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

alphafox02, 2023-10-12:
Eric,Against my better judgement again haha I followed the guide you pointed me to the T using a windows computer. All seemed to be going well till the part where I tried to erase sector and you’ll see the issue attached. Now the CatSniffer is back to a state where there’s no flashing lights when plugged in and trying to run through the above with openocd and telnet ends with same result Sent from my iPhoneOn Oct 11, 2023, at 9:35 PM, Alpha Fox ***@***.***> wrote: Just noticing this, I'm slightly confused with the directions as it looks like I'd need to set up windows and follow all steps, not sure the rp2040. However, I think my catsniffer is probably fine because I do not think I ever got into boot mode to begin with to have changed the firmware at all.If you still suggest I follow the guide above I can find a windows computer, but my time may be better spent trying to do a video call as soon as possible. On Wed, Oct 4, 2023 at 11:49 AM Eric Chavez ***@***.***> wrote:
Hello @alphafox02.
Please follow these steps to restore the Catsniffer, then follow the steps I mentioned above, this resolves the error 0x55 0x55
https://github.com/ElectronicCats/CatSniffer/wiki/08.-Restore-the-CC1352-firmware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
Best Regards!

—Reply to this email directly, view it on GitHub, or unsubscribe.You are receiving this because you were mentioned.Message ID: ***@***.***>

alphafox02, 2023-10-12:
Rp2040 is also no longer reachable by double clicking the button. Sent from my iPhoneOn Oct 4, 2023, at 11:49 AM, Eric Chavez ***@***.***> wrote:
Hello @alphafox02.
Please follow these steps to restore the Catsniffer, then follow the steps I mentioned above, this resolves the error 0x55 0x55
https://github.com/ElectronicCats/CatSniffer/wiki/08.-Restore-the-CC1352-firmware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
Best Regards!

—Reply to this email directly, view it on GitHub, or unsubscribe.You are receiving this because you were mentioned.Message ID: ***@***.***>

alphafox02, 2023-10-18:
“ You must copy the.uf2 file to the device and set it in Boot mode before you may load the file by hitting SW1.”This may have been the only area of confusion. I copied the file to the rp2040, but why is this sentence saying then set to boot mode before to may load the file? Which file? I would’ve already copied the file like it says in the first line and it seems to load it itself. When I got to the telnet part and ran the commands that’s where it failed to provide the expected result. Now all I’m able to do is plug back in the CatSniffer to a windows computer. It has no lights on, and run OpenOCD. But then all im able to do is telnet and so I have no way of reaching the rp2040. Sent from my iPhoneOn Oct 18, 2023, at 8:53 AM, Alpha Fox ***@***.***> wrote: Following up. Any suggestions on how to recover the v3 since the steps I mentioned have led to where I’m at now? I’m willing to give it another chance, heck I may even just order another one because I do want to see it all work. Sent from my iPhoneOn Oct 11, 2023, at 10:48 PM, Alpha Fox ***@***.***> wrote: Eric,Against my better judgement again haha I followed the guide you pointed me to the T using a windows computer. All seemed to be going well till the part where I tried to erase sector and you’ll see the issue attached. Now the CatSniffer is back to a state where there’s no flashing lights when plugged in and trying to run through the above with openocd and telnet ends with same result <image0.jpeg>Sent from my iPhoneOn Oct 11, 2023, at 9:35 PM, Alpha Fox ***@***.***> wrote: Just noticing this, I'm slightly confused with the directions as it looks like I'd need to set up windows and follow all steps, not sure the rp2040. However, I think my catsniffer is probably fine because I do not think I ever got into boot mode to begin with to have changed the firmware at all.If you still suggest I follow the guide above I can find a windows computer, but my time may be better spent trying to do a video call as soon as possible. On Wed, Oct 4, 2023 at 11:49 AM Eric Chavez ***@***.***> wrote:
Hello @alphafox02.
Please follow these steps to restore the Catsniffer, then follow the steps I mentioned above, this resolves the error 0x55 0x55
https://github.com/ElectronicCats/CatSniffer/wiki/08.-Restore-the-CC1352-firmware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
Best Regards!

—Reply to this email directly, view it on GitHub, or unsubscribe.You are receiving this because you were mentioned.Message ID: ***@***.***>

Closed 2023-08-30.

Thread 47 (2023-08-29):

ElectronicCats - Bricked Card? Wrote incorrect version of firmware

Dlat, 2023-08-29:

YoshiDev22, 2023-08-31:
Hello Dlat,

Thank you for contacting us.

If you loaded a different firmware version, it can brick the board and it would be necessary to reprogram it with a J-Link, please try the process again or program it in another way, but if following the steps in our guide, it still can not load the correct firmware, a J-Link will be necessary.

Let us know your findings.
Kind regards,
Electronic Cats Support Team

Closed 2023-09-01.

Thread 48 (2023-09-03):

Flashing failed to verify, stuck.

lukeswitz, 2023-09-03:
Board v2.0 - Linux & Windows

Steps to flash
- Flash arduino serialtoboot
- Successfully got to step in python flash where it says to press reset after testing the port.
- Pressed reset, next command failed with the ACK/Synch error.
- Entered flash mode again manually with button combo
- Performed the command with the sniffer_fw.hex in the 1352r bin folder (the name in the docs doesn’t exist in the repo).
- Erased and flashed, verifying then ERROR timeout waiting after Get CRC32
- Led 2 now flashes whenever connected and it won’t go back into flash or boot mode.
- Holding boot and plugging it in causes all 4 leds to blink in succession.

Did I brick it already?

Marcelol52, 2023-09-04:
Hello Luke!

Thank you for contacting us!

I am sorry to hear you are having issues with you Cat Sniffer. To better understand your situation can you share the following information with us:

- What Operating System and version are you using? Linux distribution?
- Are you following this steps on windows or linux?
- Did the borad work before?
- Is it working/recognized in the Arduino IDE?
- Please connect your board and send me a screenshot of the Device Manager of the computer (with “Ports” open) if using Windows.
- Video of the behavior of the LEDs
- Photos of both sides of the board
- If you can, please share with us your invoice to this email address: support6@electroniccats.org

Kind regards,

Marcelo Arredondo
Electronic Cats

lukeswitz, 2023-09-04:
I flashed the original ino and it performs as when it arrived. So I think there's hope...

What Operating System and version are you using? Linux distribution?
- Debian & Windows 10

Are you following this steps on windows or linux?
- Tried linux, did not work, flashed the catsnifferLora back and it operated as it did when it arrived. I then switched to a windows environment to use the TI tools as outlined. With the `serialpassthough.ino` without boot and the baud set for the RF 2, I get it showing up and starting in Packet Sniffer2  v1.8 however it isn't seen in Wireshark and no data is captured by way of direct from Sniffer2.

Did the borad work before?
- Not sure.. it wasn't recognized as any type of device using Wireshark before attempting to flash. Same output when it arrived

Is it working/recognized in the Arduino IDE?
- Yes, it shows as a COM port in Windows and a dev/tty/ACM0 in linux

Please connect your board and send me a screenshot of the Device Manager of the computer (with “Ports” open) if using Windows
- These look exactly the same as in the closed issue, the board and the Ports, COM5 is how it's recognized.

Video of the behavior of the LEDs
- They go from 1 to 4 and repeat when the passthrough with boot and boot button held on poweron

Photos of both sides of the board
- Exactly as shown in closed issue of same, its the 2.0

If you can, please share with us your invoice to this email address: [support6@electroniccats.org](mailto:support6@electroniccats.org)
- Why?

Marcelol52, 2023-09-04:
Hi Luke,

Thanks for sharing the information with me.

I will try to replicate the issue you are expriencing on my end and update you as soon as I find a solution. Also, can you point me to where you raised your previous issue? We cannot find it in our closed issues for the Cat Sniffer.

Kind regards,

Marcelo Arredondo
Electronic Cats

lukeswitz, 2023-09-04:
Thanks! https://github.com/ElectronicCats/CatSniffer/issues/46#issuecomment-1681218535

Marcelol52, 2023-09-05:
Hi Luke,

One more question, what version of WireShark are you using?

Thanks and regards,

Marcelo Arredondo
Electronic Cats

lukeswitz, 2023-09-05:
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

Stable Release: 4.0.8

Marcelol52, 2023-09-05:
Hi Luke,

If you were following our tutorial to use TI's Packet Sniffer with Wire Shark, download satable version [3.0.14 of WireShark](https://2.na.dl.wireshark.org/win32/all-versions/). You will need to unisntall both programs before installing this version of WireShark or Packet Tracer might not detect WireShark.

Thanks and regards,

Marcelo Arredondo
Electronic Cats

lukeswitz, 2023-09-05:
I must have missed that- Thanks for all the help and quick replies. Loving all the toys from DEFCON. Keep being awesome.

lukeswitz, 2023-09-05:
While it did recognize Wireshark on Sniffer install the problem remains. Can you advise which .ino to flash? Putting it into boot loader mode with the ino or buttons leads to:
`ERROR: Timeout waiting for ACK/NACK after 'Get ChipID (0x28)' ` and when its not in bootloader mode:
`ERROR: Timeout waiting for ACK/NACK after 'Synch (0x55 0x55)'  ` is that anything you've encountered? Not able to flash using Ti flash either, just error.

Marcelol52, 2023-09-06:
Hi Luke,

I hope you are having a good day!

The fact that WireShark was detected by the Packet Sniffer is a good sign. You board's chip cc1352 already comes flashed from the factory, there is no need to change the firmware. To use your board with Packet Sniffer and Wire shark, you only need to flash [SerialPasstrough.ino](https://github.com/ElectronicCats/CatSniffer/tree/master/firmware/V3.x/RP2040/SerialPasstrough) to the RP2040 using the Arduino IDE. You can follow the steps shown [here](https://github.com/ElectronicCats/CatSniffer/wiki/04.-Supported-software#smartrf-packet-sniffer-2). Check that the board works like that. If later you need help flashing firmware to the cc1352 for another specific application we can check that together.

Kind regards,

Marcelo Arredondo
Electronic Cats

lukeswitz, 2023-09-06:
I wanted to flash your custom fw, but the tool does as above when using the ino you mention. Led 2 steady flash, nothing working in wireshark and sniffer can’t see the device. When serialpassthough.ino is uploaded it can communicate with rf sniffer but isn’t recognized by wireshark or log any packets in out modes.

Marcelol52, 2023-09-06:
Hi Luke,

When you downloaded Wire Shark, did you create the [Desktop Shortcut](https://github.com/ElectronicCats/CatSniffer/wiki/04.-Supported-software#smartrf-packet-sniffer-2-setup) with the requiered properties ("C:\<path>\Wireshark.exe" -i\\.\pipe\tiwspc_data -k)? This will set up the pipe from TI's Packet Sniffer to WireShark.

Kind regards,

Marcelo Arredondo
Electronic Cats

lukeswitz, 2023-09-06:
I did allow that on install, and it's plugins recognized in Wireshark. The issue I am concerned with is the inability to flash the CC chip after that first go I describe in first comment and subsequent errors in bootloader mode. Seems I borked the fw

Marcelol52, 2023-09-06:
Hi Like,

If you are able to use WireShark now with your board and see the sniffed packets, it means your board is working fine. Give me some time to try and flash the firmware you were trying to load and see if I get any similar errors or find a solution.

lukeswitz, 2023-09-06:
>does your board have? P or R?

Crap, it's a P and I flashed the R sniffer hex..

lukeswitz, 2023-09-06:
And I am not able to capture any traffic, likely because of the bad choice to flash that. Is there a way back from this without a physical programmer?

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

Marcelol52, 2023-09-07:
Hi Luke,

The only way right now to programm the board if it was bricked is using a J-link. We have a tutorial on our Wiki about this. I suggest you look into the J-link EDU, it is the most affordable one. The programmer might also be useful for your future projects. We are currently working on tutorials to reprogram bricked boards using Raspberry Pico or Raspberry PI, but they will come out some time in the future.

Can you share with me photos of both sides of your board?

lukeswitz, 2023-09-07:
That’s what I suspected. Nah I’m good. It’ll go in the dead bin for now. Thanks for the help. A thought though; don’t lead people directly to the bootloader on the readme- nobody sees the wiki unless you explicitly point it out seeing as there’s half a dozen bricked boards in these closed comments. The docs are good but jump back and forth between linux macOS and windows. Concise instructions on the readme.md would be beneficial.

It says it comes without firmware on the chip this is why I flashed it. And I imagine that’s why others did also.

Marcelol52, 2023-09-07:
Hi Luke,

Thanks for your feedback, we value our customer a lot and apreciate their input. We will take your advice into account for updating our docs. The best of luck on your future projects.

Kind regards.

cldrn, 2023-09-08:
Another option is to ship us the hardware or meet us at a security conference and we will re-flash it for you. We are usually at most major conferences in America. When will you attend your next CON?

lukeswitz, 2023-09-08:
> Another option is to ship us the hardware or meet us at a security conference and we will re-flash it for you. We are usually at most major conferences in America. When will you attend your next CON?

Not until next year. This is a very kind offer and I’d take you up on it. Are there any v3 boards available or in prod? I can email you if that’s better.

jazhe, 2023-09-08:
Hello @lukeswitz!
Please email us to support@electroniccats.com to start the process. Yes, we do have V3 boards available. We look forward to hearing from you.

lukeswitz, 2023-09-09:
Done and done and ✅

Marcelol52, 2023-10-06:
Hi Luke,

Just to let you know that we have received your old board (v2.0) and will send you the new (v3.1) one soon.

lukeswitz, 2023-10-06:
Thanks so much for all the support and service.

Closed 2023-09-07.

Thread 49 (2023-09-25):

ElectronicCats

fe8769a, 2023-09-25:
Hello I just received my catsniffer today . I have 40 years of computers stall knowledge and the same in radio reception.

I don't know how to begun

Under windows 10 , my catsniffer is recognize as com 3 but no led are lighting
I tried to push all buttons as described in documentation -- no chance

I have plenty of windows, linux , raspi computers all kind of versions

I installed the arduino IDE on a raspi 4 using dragon OS v31 (ubuntu) trying to communicate with catsniffer

I have error in running Arduino 1.8.19 like :+1:

Arduino: 1.8.19 (Linux), Board: "Arduino Uno"

/tmp/arduino_modified_sketch_710303/sketch_sep25a.ino: In function 'void setup()':
sketch_sep25a:68:3: error: 'Serial1' was not declared in this scope
   Serial1.begin(baud);
   ^~~~~~~
/tmp/arduino_modified_sketch_710303/sketch_sep25a.ino:68:3: note: suggested alternative: 'Serial'
   Serial1.begin(baud);
   ^~~~~~~
   Serial
/tmp/arduino_modified_sketch_710303/sketch_sep25a.ino: In function 'void loop()':
sketch_sep25a:91:5: error: 'Serial1' was not declared in this scope
     Serial1.write(Serial.read());   // read it and send it out Serial1 (pins 0 & 1)
     ^~~~~~~
/tmp/arduino_modified_sketch_710303/sketch_sep25a.ino:91:5: note: suggested alternative: 'Serial'
     Serial1.write(Serial.read());   // read it and send it out Serial1 (pins 0 & 1)
     ^~~~~~~
     Serial
sketch_sep25a:94:7: error: 'Serial1' was not declared in this scope
   if (Serial1.available()) {     // If anything comes in Serial1 (pins 0 & 1)
       ^~~~~~~
/tmp/arduino_modified_sketch_710303/sketch_sep25a.ino:94:7: note: suggested alternative: 'Serial'
   if (Serial1.available()) {     // If anything comes in Serial1 (pins 0 & 1)
       ^~~~~~~
       Serial
exit status 1
'Serial1' was not declared in this scope

This report would have more information with
"Show verbose output during compilation"
option enabled in File -> Preferences.

----------------------------------------------------------------------------
Can you explain the way to use catsniffer in windows 10 with TI packets sniffer

is there any different firmware for different applications ?

What is the exact way to start catsniffer

1- serial passthrough ? how ?
2- serial passthrough with bootloader ?

-- using sniffe ? how ? different firmware ?

Thanks for help

fe8769a, 2023-09-25:
I retreived documentation early this morning and followed you on twitter .

1 - trying to put catsniffer in upload mode - no led . I tried many times
many computers
2- I installed Arduino IDE on my raspberry 4 - 4go using dragon OS (ubuntu)
and I have errors using both serialpassthroughwithboot or serialpassthrough
3- As I read on documentation, in order to use TI packet sniffer, I have to
put catsniffer in upload mode then send with arduino IDE the
serialpassthrough script , I can't because of errors
4- in catsniffer lora script I have the error radiolib.h not found

thanks for help

Le lun. 25 sept. 2023 à 20:34, Paulino Calderon ***@***.***>
a écrit :

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

--

Marcelol52, 2023-09-26:
Hi,

To better understand your situation let me know which version of the CatSniffer are you using? v1,2 or v3?

fe8769a, 2023-09-27:
hello
It is V3.1

yesterday I was able to have some leds , last down led blinking blue . When
using catsniffer buttons , I have all leds blinking one after the others .
before I have no led and now I can't switch off leds

In Arduino IDE, I don't know the way to update

SerialPassthroughwithboot.ino
or
SerialPassthroughwithboot.ino.elf.uf2

Thanks

Le mar. 26 sept. 2023 à 23:53, Marcelo Arredondo ***@***.***>
a écrit :

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

--

fe8769a, 2023-09-27:
hello

In order to use catsniffer with TI packet analyser and following the
documentation , we have to install embedded card in arduino IDE.

using this command :

git clone ***@***.***:arduino/ArduinoCore-mbed mbed

we got the following error :

sudo git clone ***@***.***:arduino/ArduinoCore-mbed mbed
Cloning into 'mbed'...
***@***.***: Permission denied (publickey).
fatal: Could not read from remote repository.

Please make sure you have the correct access rights
and the repository exists.

I tried to solve but I can't

the same with the following line :

git clone ***@***.***:arduino/ArduinoCore-API

the other line is unclear :

Create a symlink to ArduinoCore-API/api in
$sketchbook/hardware/arduino-git/mbed/cores/arduino.

what is the exact syntax

As soon as I will install catsniffer, as fast I will make a documentation

Le mar. 26 sept. 2023 à 23:53, Marcelo Arredondo ***@***.***>
a écrit :

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

--

Marcelol52, 2023-09-27:
Hi,

If you are using V3.1 and trying to use TI's Packet Sniffer you will nedd to load SerialPassthroughwithboot.ino.elf.uf2 to the RP2040 and the sniffer_fw_Catsniffer_v3.x.hex

GitHub\CatSniffer\firmware\V3.x\CC1352P7\sniffer_fw_cc1252P_7\sniffer_fw_Catsniffer_v3.x.hex
GitHub\CatSniffer\firmware\V3.x\RP2040\SerialPassthroughwithboot\SerialPassthroughwithboot.ino.elf.uf2

To load the .UF2 firmware to your board we recommend putting the RP2040 in bootloader mode by double tapping (fast as a double click) the Reset1 button. A file explorer window will open and you can drag the .UF2 file and drop it in there, it should close automatically. Using the Arduino IDE for this board model is possible but you will need to make some modifications to the core and that could impact the usability of other RP2040 boards. We recommend loading all the firmware with the .UF2 method.

For the .hex file you will need to use the python tool in out repository. You can find the procedure[ here.](https://github.com/ElectronicCats/CatSniffer/wiki/02.-CatSniffer-v1.x-and-2.x#flashing-with-python) To put the cc1352 in bootloader mode, hold reset1, hold boot1, release reset1 and wait until LED4 stops blinking and you see a swiping pattern on the other LEDs to release boot1.

If you have both of those firmwares on your board, just open TI's Smart RF Packet Sniffer 2 (v1.8) and your board will be detected and you can follow the tutorial on how to use it on our wiki in the Supported Software section. Also remember to use the suggested version of WireShark (3.0.14) and make the direct access as described [here](https://github.com/ElectronicCats/CatSniffer/wiki/04.-Supported-software#wireshark).

Regarding the lora firmware that error implies that that library (radiolib.h) is missing from your directory.

fe8769a, 2023-09-29:
Hello

the first part with copy UF2 to media is OK
the second part copy from arduino ide with SerialPassthroughwithboot.ino is
working fine

then when I plug the catsniffer there is 2 leds top and bottom blinking
alternatively

Doing the sequence key reset I have of leds swiping pattern .

when I pass the following command :

python cc2538-bsl.py -e -w -v -p COM8 sniffer_fw_Catsniffer_v3.x.hex

I have always a timeout

I tried with TI programmer same trouble , what did I do wrong?

>Initiate access to target: COM8 using 2-pin cJTAG.

>Communication initialization failed. Failed to send data.

>Connecting over serial bootloader failed: Communication initialization
failed. Failed to send data.

>Failed to create device object.

thanks for answer

Le mer. 27 sept. 2023 à 20:27, Marcelo Arredondo ***@***.***>
a écrit :

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

--

Marcelol52, 2023-09-29:
Hi,

Just to clarify a bit more, the .UF2 process is just another way to load the SerialPassthroughwithboot.ino firmware (or any other available firmware) to the RP2040, you do not need to also do it on the Arduino IDE.

The swiping pattern indicates the cc1352 is in bootloader mode (as long as the LED 4 is turned OFF).

Are you putting the cc1352 in bootloader mode when running the python commands?

Does it give the same error running the first command to open the port? <python cc2538-bsl.py -p COM08>

Can you share the complete error code?

lukeswitz, 2023-09-29:
It says there’s Linux support but is that limited to Sniffle only? Nothing else is compatible and all Windows. The pain points trying to use this are innumerable. Please create software that is simple to compile and can support your devices; or at the least some clear instructions for both Linux and Windows. I have both the 3.1 and 2.1 and both are useless without a windows desktop environment. Useless in the field. Help.

fe8769a, 2023-09-29:
So I did only the way sending UF2 to media using pressing twice on reset .
Media windows is closing

the I made the boot loader sequence , the led 4 is blinking

I send python command

python cc2538-bsl.py -e -w -v -p COM8 sniffer_fw_Catsniffer_v3.x.hex

Opening port COM8, baud 500000
Reading data from sniffer_fw_Catsniffer_v3.x.hex
Your firmware looks like an Intel Hex file
Connecting to target...
ERROR: Timeout waiting for ACK/NACK after 'Synch (0x55 0x55)'

once I have this error I have led 4 blinking and led 1 fixed

I saw on the net , we could install zadig driver like rtl-sdr SDR
Is there a special configuration of serial port because port setting is
128000 and python is sending 500000 baud rate

here is more details :

Opening port COM8, baud 500000
Reading data from sniffer_fw_Catsniffer_v3.x.hex
Your firmware looks like an Intel Hex file
For more solid firmware type auto-detection, install python-magic.
Please see the readme for more details.
Connecting to target...
*** sending synch sequence
Traceback (most recent call last):
  File
"C:\Users\PB\Documents\GitHub\CatSniffer\tools\cc2538-bsl\cc2538-bsl.py",
line 1195, in <module>
    if not cmd.sendSynch():
           ^^^^^^^^^^^^^^^
  File
"C:\Users\PB\Documents\GitHub\CatSniffer\tools\cc2538-bsl\cc2538-bsl.py",
line 372, in sendSynch
    return self._wait_for_ack("Synch (0x55 0x55)", 2)
           ^^^^^^^^^^^^^^^^^^^^^^^^^^^^^^^^^^^^^^^^^^
  File
"C:\Users\PB\Documents\GitHub\CatSniffer\tools\cc2538-bsl\cc2538-bsl.py",
line 265, in _wait_for_ack
    raise CmdException("Timeout waiting for ACK/NACK after '%s'"
CmdException: Timeout waiting for ACK/NACK after 'Synch (0x55 0x55)'
ERROR: Timeout waiting for ACK/NACK after 'Synch (0x55 0x55)'

best regards

Le ven. 29 sept. 2023 à 20:10, Marcelo Arredondo ***@***.***>
a écrit :

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

--

Marcelol52, 2023-09-29:
> It says there’s Linux support but is that limited to Sniffle only? Nothing else is compatible and all Windows. The pain points trying to use this are innumerable. Please create software that is simple to compile and can support your devices; or at the least some clear instructions for both Linux and Windows. I have both the 3.1 and 2.1 and both are useless without a windows desktop environment. Useless in the field. Help.

Hello,

We apologize for any inconvenience you've faced while trying to use our devices on Linux. We truly value your feedback and understand the importance of having a seamless experience across different operating systems, especially in field applications.

Your input is invaluable, and we're committed to addressing these pain points. While we cannot provide an immediate solution, please rest assured that we're taking your feedback into account as we continue to enhance our products and offer clearer instructions for both Linux and Windows users.

We appreciate your patience and dedication to our products.

Marcelol52, 2023-09-29:
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

Thank you for providing detailed information about the issue you're facing with updating the firmware on your CatSniffer.

We will test a CatSniffer board on our end to replicate the issue you're experiencing. This will help us identify any potential device-specific issues and find a solution for you.

We appreciate your patience as we work to resolve this matter.

Marcelol52, 2023-10-03:
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

Hi,

Try to follow [this tutorial](https://github.com/ElectronicCats/CatSniffer/wiki/08.-Restore-the-CC1352-firmware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) on our wiki to restore the cc1352 chip on your board. Sometimes after loading a firmware the bootloader might get stuck and erasing the memory fixes the issue. After that try to use the python tool to flash the firmware again. If you ecounter any issues with the tutorial do not hesitate to comment here again.

Good luck!

fe8769a, 2023-10-04:
Before try on with cc1352 reset . Let make sure on catsniffer status led .
When I put catsniffer on USB . I have top up led fixed and bottom down blinking , PC recognize as raspi pico on usb . peripherical serial USB on COM9 . What is this state ? good or faulty ?
Using sequence reset1 boot release reset and boot , the bottom down led is blinking
After sending .hex file with cc2538-bsl and having the error Timeout waiting for ACK/NACK after 'Synch (0x55 0x55)
3 bottom down leds are on and le 4th is blinking

If catsniffer is in error please explain the way to reset (this tutorial)

Thanks

Marcelol52, 2023-10-04:
Hi,

The LED pattern you discribe is not a 'faulty' one, but it does mean that the cc1352 is not going into bootloader mode. If you have SerialPassthroughwithboot.ino.elf.uf2 on the RP2040, after putting the cc1352 in bootloader mode, LED 4 should stop blinking and the other 3 LED's should be doing a swiping pattern. To put the cc1352 in bootloader mode, press and hold the BOOT1 button, tap the RESET1 button and then finally release the BOOT1 button. If it doesn't work the first time, try doing it a bit slower. You have to see the swipping patter and LED 4 should be **OFF**. If the cc1352 is not on bootloader mode, you will keep getting the  error Timeout waiting for ACK/NACK after 'Synch (0x55 0x55). If that does not work try with ereasing the chip as I mentioned before.

Good luck!

fe8769a, 2023-10-04:
tutorial of catsniffer is faulty

./configure --disable-werror --enable-picoprobe

need to install gcc .

libusb1.0 is not present . When trying to install it , error in make !!

Marcelol52, 2023-10-04:
Hi,

We are sorry you are experiencing this issues, we constantly try to update our Wiki. We are currently in the porcess of a big restructure of the Wiki to add valuable details and update many things. We apreciate your patience so far.

Try following the steps in the tutorial using MSYS2 MINGW64 insted of MSYS2 MSYS.  If you get the gcc error again you will just need to install it, if you need help with that let me know.

alphafox02, 2023-10-04:
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

I have tried every way possible to get a firmeware flashed on the v3 and it always ends with Timeout waiting for ACK/NACK after 'Synch (0x55 0x55). However, it just occurred to me I was not hitting reset1. So I corrected that, but I still up up with a sweeping patter of lights towards led 4, but led 4 is still blinking as well.

Marcelol52, 2023-10-04:
Hi,

I will try to replicate this behavior with the LED's and get back to you.

lukeswitz, 2023-10-04:
>> but I still up up with a sweeping patter of lights towards led 4, but led 4 is still blinking as well.

Had same with same error. Still waiting for them to fix it. They’ve had it a while. I’ve lost hope for it at this point.

alphafox02, 2023-10-04:
I got mine back, don't lose hope yet. I will say, I've attempted to flash it more times then I'd like to admit...

alphafox02, 2023-10-07:
> Hi,
>
> I will try to replicate this behavior with the LED's and get back to you.

Good morning. After loading your v3.1 rp2040 with the serial pass through with boot, unplugging and plugging back in do you get two blinking blue lights? When you follow your recommend procedure to then enter boot mode are you getting all three leds 1-3 making a sweeping motion? Do you also get the 4th led blinking on and off? Or just 4th led off? I get the sweeping motion 1-3, but also 4th led blinking. I’ve tried numerous times at different speeds, different length usbc cables, different computers (all Linux) and each time I get the same result which seems like I’m not getting into boot loader mode. Is there perhaps any other method? If I can get perhaps the sniffle firmware loaded I can maybe do something in Linux.

Marcelol52, 2023-10-09:
"Good morning. After loading your v3.1 rp2040 with the serial pass through with boot, unplugging and plugging back in do you get two blinking blue lights? When you follow your recommend procedure to then enter boot mode are you getting all three leds 1-3 making a sweeping motion? Do you also get the 4th led blinking on and off? Or just 4th led off? I get the sweeping motion 1-3, but also 4th led blinking. I’ve tried numerous times at different speeds, different length usbc cables, different computers (all Linux) and each time I get the same result which seems like I’m not getting into boot loader mode. Is there perhaps any other method? If I can get perhaps the sniffle firmware loaded I can maybe do something in Linux."

Hi,

After loading the SerialPassthroughwithboot.ino (v3.x from the repository) to the RP2040. yuo should have D3 (LED3) static and LED4 blinking. That is the normal status and indicates the board is working fine. When putting the board in bootloader mode you should have a swiping patter going from D3 to D1 and D4 should be OFF. When D4 is of it means the cc1352 chip has gone into bootloader mode. At this point is where you can use the python tool ([cc2538-bsl](https://github.com/ElectronicCats/CatSniffer/tree/master/tools/cc2538-bsl)) to load the firmware to the cc1352.

The only other available method is using a JLINK or similar cJTAG programmer to load the firmware to the cc1352 using the JFlash lite software. There is also a [guide](https://github.com/ElectronicCats/CatSniffer/wiki/08.-Restore-the-CC1352-firmware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) for this on our Wiki.

If you want, we can schedule a videocall to get your board working with other firmwares. Let me know if this would be an option for you.

alphafox02, 2023-10-10:
A video call will be great. Once I have it working I will in turn make videos and share with others. I’m on EST time. Let me know some days/times that work and I will arrange for everything to be setup on my end.

Marcelol52, 2023-10-10:
Hi,

Our working hours go from 10 am to 6 pm CST, Monday through Friday. Let me know which would be the best time for you.

alphafox02, 2023-10-11:
> "Good morning. After loading your v3.1 rp2040 with the serial pass through with boot, unplugging and plugging back in do you get two blinking blue lights? When you follow your recommend procedure to then enter boot mode are you getting all three leds 1-3 making a sweeping motion? Do you also get the 4th led blinking on and off? Or just 4th
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

Thread 50 (2023-10-01):

Software support for Linux

lukeswitz, 2023-10-01:
> We apologize for any inconvenience you've faced while trying to use our devices on Linux. We truly value your feedback and understand the importance of having a seamless experience across different operating systems, especially in field applications.

No need to apologize. The product is great, but its capabilities are limited behind the TI & Windows hobbyist environment requiring deprecated versions. Serial output should be standard, so at the least we can see what the sniffer sees as referenced in the workshop BLE spoof/sniff modules.

Sniffle is a mess to compile, then doesn’t seem to work. And your docs tell us if we want to use pre-compiled builds the only way is with Uniflash which doesn’t work on most Linux distributions.

I’ve gotten it to show airtags, but disheartening was the fact that an app on my phone did the same and found an equal amount.

Is a new plugin/script for wireshark possible to solve this? Has anyone found anything that works with this device?

Lastly, does the device need the serial pass though flashed to see the output of the AirTag fw from the CC chip? Any help appreciated. Thanks all.

wero1414, 2023-10-01:
Hello!

Thanks for the feedback, we are still working on improving the documentation with all the updates we have been working.

In the mean time, i would like you to know that the pre-compiled version of sniffle is already available in the repository, so you can use it with the sniffle software, and you can flash the catsniffer with the [python tool](https://github.com/ElectronicCats/CatSniffer/tree/master/tools/cc2538-bsl) on any OS.

May i know what catsniffer version do you own? cause that will determine what wireshark version can you use, we have been working on reverse the serial commands that the TI sniffer gives us but it is still a WIP you can find that [software here](https://github.com/ElectronicCats/CatSniffer/tree/master/tools/pycatsniffer) we are missing the wireshark plugin connection and dissectors.

and for the finall question, yes you need to have the serialpasstrough to see the output, we are trying to normalize all the usage of the CC1352 serial port with the 921600 bauds speed, so you can always see the messages and avoid the change on speed on the RP2040 or SAMD21 uC.

I hope i clear things a little bit, if not the support team will lead you with each question you may now have.

alphafox02, 2023-10-02:
I've got one back in hand now and working on getting whatever is needed in DragonOS (Linux) working with it.

Marcelol52, 2023-10-03:
Hi,

No these are not currently compatible with Linux.

cldrn, 2023-10-03:
@Marcelol52 The dissectors are universal, they work with any OS.

Marcelol52, 2023-10-03:
Thanks for the correction Paulino. Sorry for not specifying, I meant wireshark. I didn't see any download for Linux on their page.

alphafox02, 2023-10-06:
Further clarification, with the CatSniffer v3.1, what can one use it with in Linux? If I receive the CatSniffer from the factory and leave the default firmware on it as it arrived, should I be able to use the python file sitting inside pycatsniffer or is there something else I should be able to use it with?

alphafox02, 2023-10-06:
"This tool is intended to be an alternative to the Windows-based SmartRF Packet Sniffer 2 program using TI's default firmware on CC13XX chips (and combine it with Wireshark's live capture utility). pycatsniffer has been developed on Linux."

Reading this statement again makes me wonder, does the CatSniffer v3.1 arrive from the factory with the "TI's default firmware" loaded on it or is it some other firmware?

alphafox02, 2023-10-06:
But to expand on this, reading up above

"May i know what catsniffer version do you own? cause that will determine what wireshark version can you use, we have been working on reverse the serial commands that the TI sniffer gives us but it is still a WIP you can find that [software here](https://github.com/ElectronicCats/CatSniffer/tree/master/tools/pycatsniffer) we are missing the wireshark plugin connection and dissectors."

It would seem that even if the CatSniffer v3.1 arrived with the "TI's default firmware" to use with pycatsniffer that again the wireshark plugin connection and dissectors are not available.

So this leads me to believe that perhaps for the time being I can't use my CatSniffer for anything in Linux since I can't seem to load an alternate firmware (Sniffle?) and pycatsniffer is missing the wireshark pieces. Would this be safe to say?

lukeswitz, 2023-10-06:
Yet to get the 2.1 or 3.1 to work with Linux. But the docs and instructions will let you flash with Linux just can’t use it for anything. Only works with v3 wireshark, I’m not here to chase legacy builds for a shiny new product. In the bin with it until someone gets around to documenting how to make it work with Linux or writes some proper scripts for it. Massive waste of time and money so far.  I’ll wait for them to sort it out until then ubertooth just works.

Marcelol52, 2023-10-06:
Hi,

Just wanted to adress some of your feedback as best as I can.

"Further clarification, with the CatSniffer v3.1, what can one use it with in Linux? If I receive the CatSniffer from the factory and leave the default firmware on it as it arrived, should I be able to use the python file sitting inside pycatsniffer or is there something else I should be able to use it with?"

Yeah, the firmware that comes preloaded with the board is the SerialPassthrough and the sniffing firmware on the cc1352. That should work with the python tool pycatsniffer.py.

"Reading this statement again makes me wonder, does the CatSniffer v3.1 arrive from the factory with the "TI's default firmware" loaded on it or is it some other firmware?"

It comes with the latest version of the sniffing firmware that you can find on our repository.

"So this leads me to believe that perhaps for the time being I can't use my CatSniffer for anything in Linux since I can't seem to load an alternate firmware (Sniffle?) and pycatsniffer is missing the wireshark pieces. Would this be safe to say?"

For now the pycatsniffer.py tool is on a develpment stage, we are working on it to be an alternative to the SmartRF Packet Sniffer from TI that would work on any OS. It is true it is still missing some things, but we are planning on getting a better version out by the start of next year. This is a rather complex application and it is taking some time to get developed.

Regarding the other 3 available firmwares on our repository, you can load any of them using the python tool using linux. And they all work with the OS as well.

There is also the option of developing custom firmwares to use with the board, we have a tutorial on the wiki for this too.

We are also currently working on a big restructure of our wiki, to make it easier to understand, add more detailed tutorials and update some data.

We really appreciate your interest and effort when it comes to our products. We encourage you to stick around and contribute to this project. Even with just your feedback you help us a lot with making our products better.

Hope this clarified most of your doubts, if you have any other or I did not adress somthing here, don't hesitate to comment here again.

Hope you have a great day!

alphafox02, 2023-10-06:
That was super helpful clarification. I do have a remaining problem for the time being. It’s not possible for me to flash the firmware to anything else besides what came from the factory, so unfortunately I can’t test anything within Linux. I’ve loaded the rp2040 boot file, attempt to put it on boot loader using now the correct button pushes, but ultimately I end up with a sweeping motion on three lights with the 4th led blinking. It’s been confirmed elsewhere the 4th led should be off. So in my case every time I try to flash a firmware with the python tool it fails.

This brings me back to my initial suspicion, that for the time being I can’t really use it for anything in Linux until either the pysniffer tool is all working or I figure out why I can’t get into bootloader mode.

lukeswitz, 2023-10-07:
>
> For now the pycatsniffer.py tool is on a develpment stage, we are working on it to be an alternative to the SmartRF Packet Sniffer from TI that would work on any OS. It is true it is still missing some things, but we are planning on getting a better version out by the start of next year. This is a rather complex application and it is taking some time to get developed.
>

That’s good, but the python script alone doesn’t work. In your docs it’s all a mess. Please provide steps how to compile your tool for Linux and what **linux** dependencies it requires

alphafox02, 2023-10-07:
What I’m tracking and seeing is they pyCatSniffer is what you’d use in Linux, but as mentioned above it’s not fully compete yet. You don’t really have to compile anything and dependencies are listed in the pyCatSniffer directory.. but it’s not all complete yet for Linux. The sniffle firmware is built already, but unfortunately for me I can’t seem to currently flash my 3.1 to anything else, otherwise I’d make some video tutorials in DragonOS this weekend and share usage within Linux.

lukeswitz, 2023-10-07:
It’s looking for a serial device and fails is my experience. The code does work in theory

Marcelol52, 2023-10-09:
" That’s good, but the python script alone doesn’t work. In your docs it’s all a mess. Please provide steps how to compile your tool for Linux and what **linux** dependencies it requires as TI doesn’t support many distros. Your docs only show TI SDK being used in conjunction with it and witeshark and it’s all windows based. It’s just so confusing for a simple tool."

Hi,

There is no need to compile anything for the tool. Check the instructions on how to use the tool on the [README.](https://github.com/ElectronicCats/CatSniffer/tree/master/tools/pycatsniffer)

If you want to, we can schedule a videocall to solve some of the questions you have.

lukeswitz, 2023-10-10:
please post a video of your software working and the tools in use. That will be most helpful instead of the cart pushing the horse. Thanks

Marcelol52, 2023-10-10:
Hi Luke,

There is more documentation that could help you about [Sniffle on their repository](https://github.com/nccgroup/Sniffle). We are working a restructure of the whole CatSniffer Wiki. We expect to have it by next week. We will have some video/GIF examples of the different firmwares and softwares working with the CatSniffer. I can only ask you right now to be patient for a little longer.

Marcelol52, 2023-10-18:
Hi Luke,

We will close this issue for now. The new Wiki will be out soon and there will be a more detailed section on how to use Sniffle.

lukeswitz, 2023-10-18:
Cool, thanks for all the help!

Closed 2023-10-18.

Thread 56 (2023-11-09):

Catsniffer not detected by PC - Windows 10

AdMiZaSa, 2023-11-09:
Hi, so I ordered a V2 Catsniffer in July this year and due to a work move have only recently taken it out of the bag.

I'm hoping to use it on a Windows 10 laptop with TI Packet Sniffer software.  Have downloaded V1.8.

But, when I connect the Catsniffer via the USB lead to the PC it isn't detected and doesn't show in device manager.

Having read other issues I saw that Win8 had issues which had been solved by Zadig so downloaded that but Zadig doesn't see the CS either.

I have also tried to communicate with the board using the Arduino IDE but it doesn't show on that.

That said, when I plug it in I get a slow flash on led D4 so it is powering up and I think I can put it into bootloader mode by holding boot switch and applying power then releasing boot switch and led doesn't flash.

Can you think of a way to get the laptop to see the device?

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

Marcelol52, 2023-11-10:
Hi,

Are you able to put the board's RP2040 into bootloader mode by doble pressing the reset1 button? You will need to press it fast as a double click on a mouse. It will open a windows for a mass storage device. If you are able to put the board into bootloader mode, try loading the [SerialPassthroughwithboot.ino](https://github.com/ElectronicCats/CatSniffer/blob/master/firmware/V1.x_V2.x/SAMD21E17/SerialPassthroughwithboot/SerialPassthroughwithboot.ino) but in .uf2 format. Drag and drop it on the open window. You can check the wiki on how to [upload firmware](https://github.com/ElectronicCats/CatSniffer/wiki/04.-Upload-Firmware#uf2-recommended-for-rp2040) this way. If you need help compiling the .uf2 version or you are not able to put the board into bootloader mode let me know.

AdMiZaSa, 2023-11-11:
Hi,

Tried that and everything remains the same:

Plug the board in Slow flash D4 - not showing in device manager, Zadig or Arduino.

Plug board in with Boot1 pressed, release Boot1, No D4 flash but still doesn't show in DM, Zadig or Arduino.

Plug board in slow flash D4, double click Reset1 no change - slow flash D4 and device not seen.

And, just in case, press Boot1, plug in, no flash D4, double click Reset1 - no flash D4 and device not seen.

So, might be going into Bootloader mode but not showing up as a device I can talk to with anything I have on this laptop.

Thoughts?

Marcelol52, 2023-11-13:
Hi,

If it is possible for you, we can schedule a video call to verify the status of the board. Let me know if this is a viable option for you so I can schedule the meeting. Thanks

AdMiZaSa, 2023-11-15:
Hi Marcelo,

That would be great if we could. I am currently working gmt +3.

What's your preferred method of comms?

Marcelol52, 2023-11-16:
Hi,

We can have the meeting next monday at 10:00 A.M. CST Mexico. We use Goolge Meet, please send an email to support6@electroniccats.org with the email adress you would like to set up the meeting with.

Marcelol52, 2023-11-16:
Hi,

Please send an email to support6@electroniccats.org so we can set up the meeting.

Thanks

AdMiZaSa, 2023-11-16:
Hi, that will be 1900 my time. Should be acie eagle. Do I need to download anything for Google meet?

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

Thread 67 (2024-01-25):

PyCatSniffer + Wireshark not working on MacOS

zkvL, 2024-01-25:
**Describe the problem:**
When trying to capture BLE ADV packets on MacOS with PyCatSniffer no packets are shown.

**To Reproduce:**
1. Entered the CatSniffer board into bootloader by holding BOOT1 + Press and Release RESET 1 + Release BOOT1
 - Tried copying `SerialPassthroughwithboot.ino.elf.uf2` to RPI-RP2 before entering bootloader mode and without the SerialPassthrough
2. When LEDs were blinking in waterfall mode, I proceeded to flash the firmware

On MacOS flashed the firmware using catnip:
```bash
❯❯❯ python3 catnip_uploader.py releases
Releases available:
0: airtag_scanner_CC1352P_7.hex
1: airtag_spoofer_CC1352P_7.hex
2: sniffer_fw_CC1352P_7.hex
3: sniffle_CC1352P_7.hex

❯❯❯ python3 catnip_uploader.py load 2 /dev/cu.usbmodem14401
[...]
Connecting to target...
CC1350 PG2.0 (7x7mm): 704KB Flash, 20KB SRAM, CCFG.BL_CONFIG at 0x000AFFD8
Primary IEEE Address: 00:12:4B:00:2A:79:C0:94
    Performing mass erase
Erasing all main bank flash sectors
    Erase done
Writing 720896 bytes starting at address 0x00000000
Write 208 bytes at 0x000AFF308
    Write done
Verifying by comparing CRC32 calculations.
    Verified (match: 0x52c24bf8)
Done uploading sniffer_fw_CC1352P_7.hex to /dev/cu.usbmodem14401
```

3. Installed Wireshark dissectors by copying the content of:
```bash
.dissectors:
├── catsniffer-blepi.lua
├── catsniffer-register.lua
└── catsniffer-rpi.lua
```
to the Personal LUA Plugins Path on Wireshark. For MacOS it was: `$HOME/.local/lib/wireshark/plugins`

4. Configured the DLT 147 value

5. Ran `cat_sniffer.py`
```bash
❯❯❯  python3 cat_sniffer.py sniff /dev/cu.usbmodem14401 -phy 0 -ch 37 -pf -pfn catsniffer.pcap -df -ff -ws
[...]
PyCat-Sniffer CLI - For sniffing the TI CC1352 device communication interfaces.
Type help or ? to list commands.

PycatSniffer CLI> 2024-01-25 13:49:01.709 Wireshark[73878:8530619] WARNING: Secure coding is not enabled for restorable state! Enable secure coding by implementing NSApplicationDelegate.applicationSupportsSecureRestorableState: and returning YES.
 ** (wireshark:73878) 13:49:04.823974 [GUI WARNING] -- Populating font family aliases took 123 ms. Replace uses of missing font family "SF Mono" with one that exists to avoid this cost.
 ** (wireshark:73878) 13:49:05.148722 [Capture MESSAGE] -- Capture Start ...
```

**Expected behavior:**
BLE packets being captured on Wireshark/CatSniffer

**Screenshots:**
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

**Additional context:**
Also tried on a VM Linux using the same methods to flash the board, and a Windows VM with SmartRF Packet Sniffer (uploaded `SerialPassthroughwithboot.ino` in this case as the wiki says)
- For Linux VM I got the same behavior as with MacOS
- For Windows VM, the SmartRF Packet Sniffer  is not able to detect the CatSniffer board

I tried to capture Flipper Zero BLE spam attack packages and starting pairing mode on IoT devices.

**Tested environment**
- MacOS Sonoma 14.0 (23A344)
- VM Kali Linux 6.0.0-kali3-amd64
- VM Windows 10 x64

JahazielLem, 2024-01-25:
When the firmware is finished uploading the LEDS are blinking in what sequence?
Try when the firmware is done, reset the board with the RESET button from the CC1352 and the RP2040 or disconnect and connect the board, before running the pycatsniffer.py.

wero1414, 2024-01-26:
Hello @zkvL did you download the latest version of the serialPasstrhough firmware?

Please check that is the same version as the latest you can find it here:

https://github.com/ElectronicCats/CatSniffer-Firmware/releases/tag/board-v3.x-v1.1.0

zkvL, 2024-01-26:
Copied the latest version @wero1414 and that seemed to be the issue, Thanks!

Closed 2024-01-26.

Thread 72 (2024-04-22):

(Request) RemoteID Sniffing and Decoding Bluetooth

alphafox02, 2024-04-22:
I think perhaps decoding RemoteID per the most recent standard required on US/Europe drones would be handy if accomplished by CatSniffer.

I was reading over this link,
https://github.com/opendroneid/opendroneid-core-c?tab=readme-ov-file

And this caught my attention under this section
https://github.com/opendroneid/opendroneid-core-c?tab=readme-ov-file#bluetooth-sniffing

“ Using Texas Instruments Bluetooth boards, it should be possible to use this SW to pick up all Bluetooth advertisements from a transmitter: https://github.com/nccgroup/Sniffle “

It may just be a matter of using CatSniffer, Sniffle, and the Wireshark dissectors from the link above. I see CatSniffer is up to what appears to be 1.7 Sniffle and I recall in the past being able to get the Wireshark Sniffle connection working.

alphafox02, 2024-04-22:
WiFi RemoteID decoding would be great too. I just realized all the repositories are split up with software being separate from this repo. Assuming software requests should move there.

alphafox02, 2024-04-22:
I’ve pulled in those to my Wireshark to combine with Sniffle extcap Wireshark + CatSniffer, but I need to setup RemoteID (open droneid) transmissions to test decoding. It’ll be nice if one day possible to do everything in one native with the CatSniffer sniffer tool. One step at a time though. :)

https://github.com/opendroneid/wireshark-dissector

Marcelol52, 2024-04-22:
Hi Alphafox02. Thank you for sharing this request with us. We always appreciate you guys bringing to our attention exciting things like this.

Indeed, we have separated the CatSniffer project in three different repositories, this was done in order to have a better control on releases for the board. The main [CatSniffer](https://github.com/ElectronicCats/CatSniffer) repository will be kept for the Hardware, and we have made two new repositories for [CatSniffer Tools](https://github.com/ElectronicCats/CatSniffer-Tools) and [CatSniffer Firmware](https://github.com/ElectronicCats/CatSniffer-Firmware).

You are correct, we do have compatibility with Sniffle and Wireshark, we have a [tutorial ](https://github.com/ElectronicCats/CatSniffer/wiki/06.-Supported-Software#using-sniffle-with-wireshark)on our WiKi on how to get them working. Also, if you are able to get it working, share your progress with us. We appreciate all contributions.

sabas1080, 2024-04-22:
Hi This feature will be performed by @JahazielLem coming soon

alphafox02, 2024-04-23:
Thanks for the follow ups! I plan to order a known legitimate RemoteID transmitter and test this open source opendroneID repo against it just to see if I can get decodings. My understanding is open droneid and remoteID are the same thing, so I assume since it sounds like the standards are public and if vendors follow them, the code above should hopefully work.

alphafox02, 2024-04-28:
I thought perhaps this would also be a good reference as it seems to be verified working to some extend with bluetooth and detecting both legacy bt4 but also bt5 long range and some other features or so it sounds like.

https://github.com/dronetag/drone-scanner

Details on the bluetooth capabilities
https://github.com/dronetag/drone-scanner/blob/master/docs/features.md

alphafox02, 2024-05-09:
Please have a peek here, seems promising.

https://github.com/nccgroup/Sniffle/issues/74

Closed 2024-06-24.

Thread 75 (2024-06-09):

Does the official Sniffle work with CatSniffer?

victorhooi, 2024-06-09:
Sorry if this is a stupid question - but does the official Sniffle project work with the CatSniffer? Or do you need to patch it to work with the CatSniffer device?

I saw that there's downloadable CatSniffer firmware files here (v1.1.0) that was released January 19, 2024:

https://github.com/ElectronicCats/CatSniffer-Firmware/releases/

And one of those is a CatSniffer Sniffle firmware file ([sniffle_CC1352P_7_v1.7.hex](https://github.com/ElectronicCats/CatSniffer-Firmware/releases/download/board-Iv3.x-v1.1.0/sniffle_CC1352P_7_v1.7.hex)).

There also seems to be a ElectronicCats fork of the Sniffle - although it's last updated 3 years ago:

https://github.com/ElectronicCats/Sniffle

If you look at the official NCCGroup Sniffle repo - it's a bit confusing, because they also have a version 1.1.0 - but that was released June 3, 2024 (i.e. 4 days ago):

https://github.com/nccgroup/Sniffle/releases

Can we use those releases on your board? Or is there somewhere we can see the differences?a

cschweers, 2024-06-09:
@victorhooi try to expand your reading skills, the Sniffle release version from June 3rd is **1.10.0** ...

Marcelol52, 2024-06-10:
Hi @victorhooi, we do some modification to the tool to be able to compile it for the CatSniffer. Right now the [latest version](https://github.com/ElectronicCats/CatSniffer-Firmware/releases/tag/board-v3.x-v1.1.0) compiled for the CatSniffer is version 1.7.

victorhooi, 2024-06-11:
@Marcelol52 Ah got it - thanks for explaining!

I believe Sniffle 1.7 is quite old (2022):

https://github.com/nccgroup/Sniffle/releases/tag/v1.7

Do you know if your modifications to get it to work on the CatSniffer are available anywhere online?

And would it be quite difficult to get the recent versions of Sniffle (e.g. [Sniffle 1.10.0](https://github.com/nccgroup/Sniffle/releases/tag/v1.10.0)) working on the CatSniffer?

Also - I previously purchased a CatSniffer V2 - is there much advantage to ordering a CatSniffer V3 as well?

Marcelol52, 2024-06-18:
@victorhooi We will close this issue now, however, please feel free to reach out to us again in case you have further suggestions, encounter an issue, or you would like to contribute.

Closed 2024-06-18.

Thread 77 (2024-06-27):

LoRa sniffing - how to?

gertrudem, 2024-06-27:
I currently have a CatSniffer V3.1. I have been able to use pycatsniffer for Zigbee sniffing without an issue, I am liking it so far.

I am a beginner when it comes to using technology like this, so I hope you will be patient with me. I had a few questions about sniffing LoRa with CatSniffer.

The device is the same as it arrived from factory, although I did flash the SerialPassthroughwithboot UF2 firmware.

I noticed that CatSniffer has a chip dedicated for LoRa. However, there seems to be very little information on how to actually use it (LoRa-CLI). Can you please help me out in using the LoRa-CLI sniffer tool? How do I run it, will I be needing to use Arduino IDE?

Also, I saw that ElectronicCats sells the CatWAN USB stick which is capable of sniffing LoRa and LoRaWAN. I am not sure if this is the right place to ask, please let me know if otherwise.

When it comes to sniffing LoRa/LoRaWAN, are there any reasons as to why someone should get CatSniffer rather than CatWAN, or vice versa?

For feedback, I would love to see an update to the LoRa sections of the Wiki. Seeing some examples of the LoRa sniffer in use would be helpful.

Thank you

Marcelol52, 2024-06-28:
Hi there, the LoRa-CLI is documented on one of our other repositrories. You can check how to use it following the steps mentioned [here](https://github.com/ElectronicCats/CatWAN_USB_Stick/wiki/5.-Examples#using-lora-sniffer-tool). Right now we do not have a precompiled version of that firmware for the CatSniffer, but we are currently working on it and it should be up in a few days. When the UF2 is ready, you should be able to upload it to the board following the smae preocess used for the SerialPassthrough. The process to upload the firmware using the Arduino IDE is also documented in the CatWAN-USB-Stick repository, you can check that [here](https://github.com/ElectronicCats/CatWAN_USB_Stick/wiki/4.-First-Steps-with-CatWAN-USB-Stick). You need to use the steps for the RP2040 version.

Regarding your other questions, the CatSniffer is a more powerful and capable device. It works for many protocols, not just LoRa, as the CatWAN does.

We really appreciate your feedback and will be taking it into account for future updates for the Wiki. Comments like yours help us keep growing.

cldrn, 2024-06-28:
You can follow along the progress here: https://github.com/ElectronicCats/CatSniffer-Tools/issues/23

As Marcelo mentioned, you may use the same software, but we are also adding a custom sniffer with channel hopping for the catsniffer.

Marcelol52, 2024-07-05:
Hi @gertrudem, we will close this issue for now. Do not hesitate to contact us again if you have any other questions or issues.

Marcelol52, 2024-07-05:
Hi @gertrudem, we will close this issue for now. Do not hesitate to contact us again if you have any other questions or issues.

gertrudem, 2024-07-18:
Hello,

Thank you for your responses.

I was wondering, is there an ETA for the LoRa-CLI firmware UF2 for CatSniffer? I looked at the link cldrn posted, but there did not seem to be much activity. I would prefer not using the Arduino IDE method, but no worries if it will take time! I do not mean to rush.

Thank you

Marcelol52, 2024-07-19:
@gertrudem On our [latest release](https://github.com/ElectronicCats/CatSniffer-Firmware/releases/tag/board-v3.x-v1.1.0) there are two LoRA_CLI firmwares that you can use. They are still on a testing stage but you can start working with them.

gertrudem, 2024-07-19:
I completely missed that, thanks so much!

Closed 2024-07-05.
