ElectronicCats/CatSniffer/hardware/CatSniffer.pdf

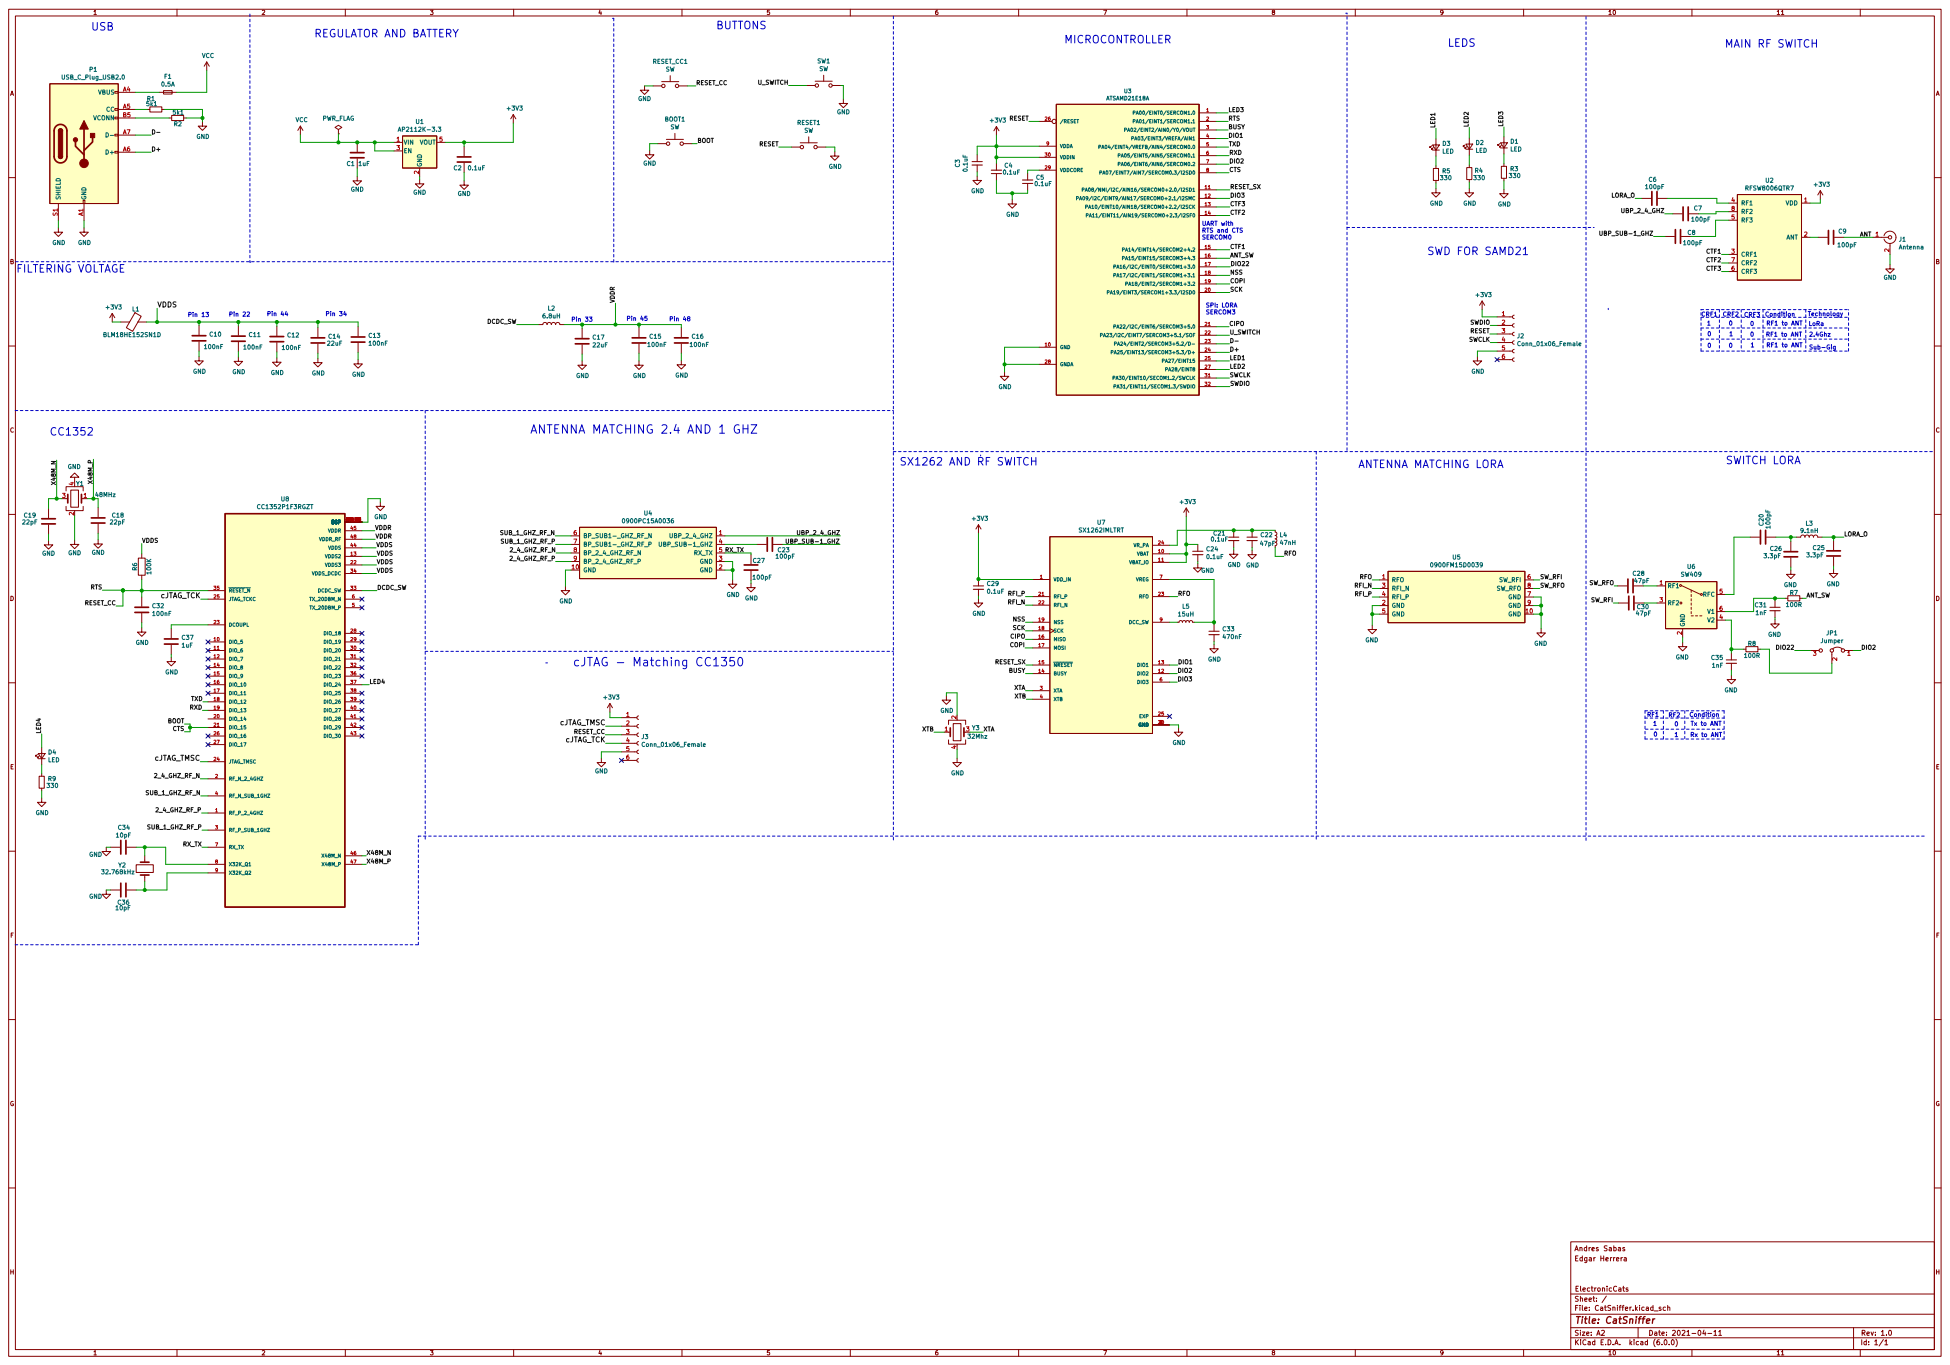
[picture p24: page 1]

1 UART with RTS and CTS

0 ANTENNA MATCHING 2.4 AND 1 GHZ
