ElectronicCats/CatSniffer/hardware/CatSniffer.kicad_pcb

## KiCad design hardware/CatSniffer.kicad_pcb (2025-01-15)

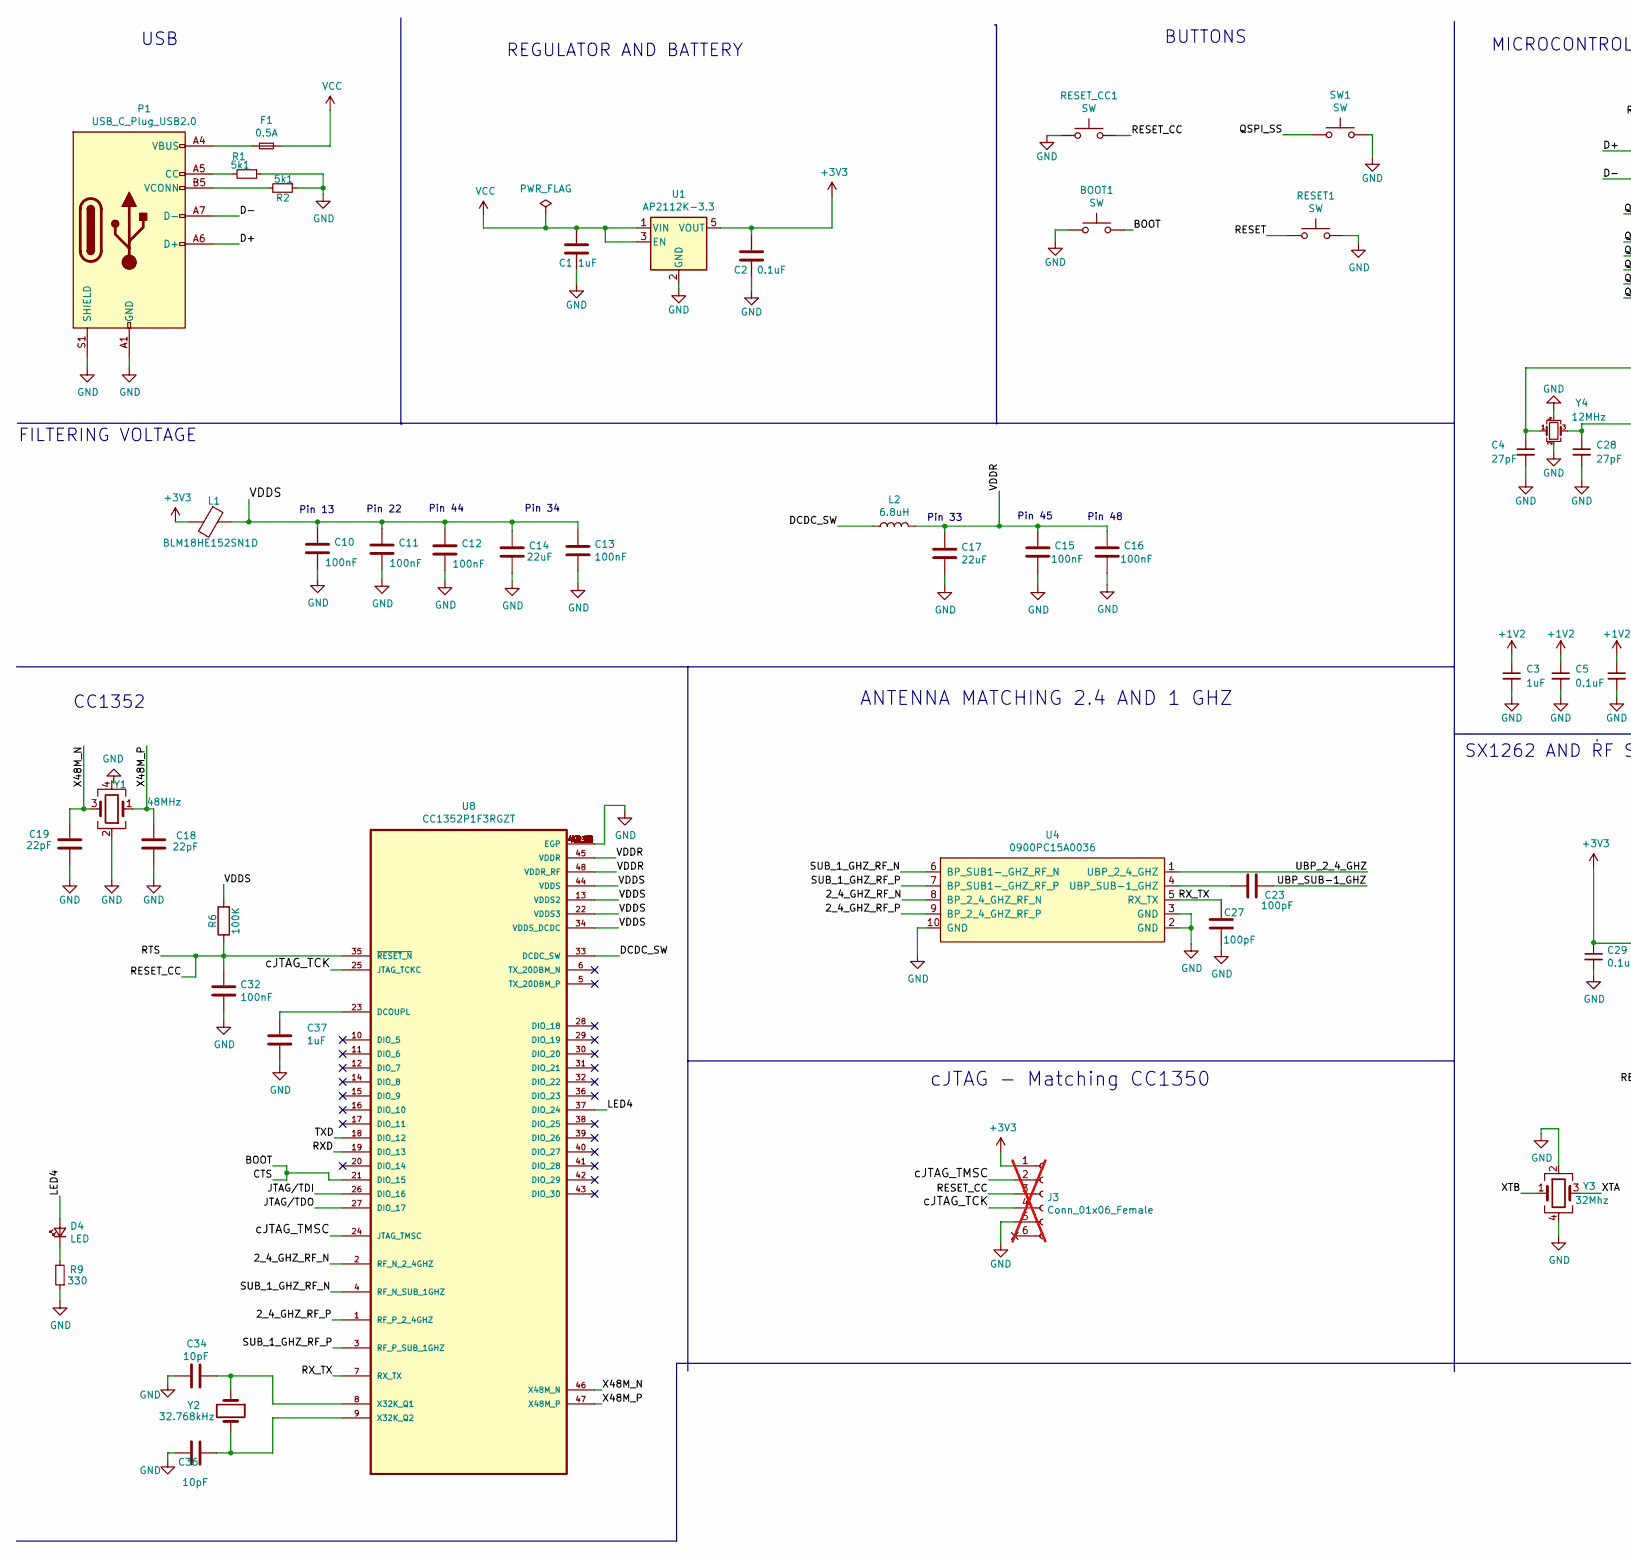
[picture p25: schematic CatSniffer.kicad_sch, part in row 1, column 1]

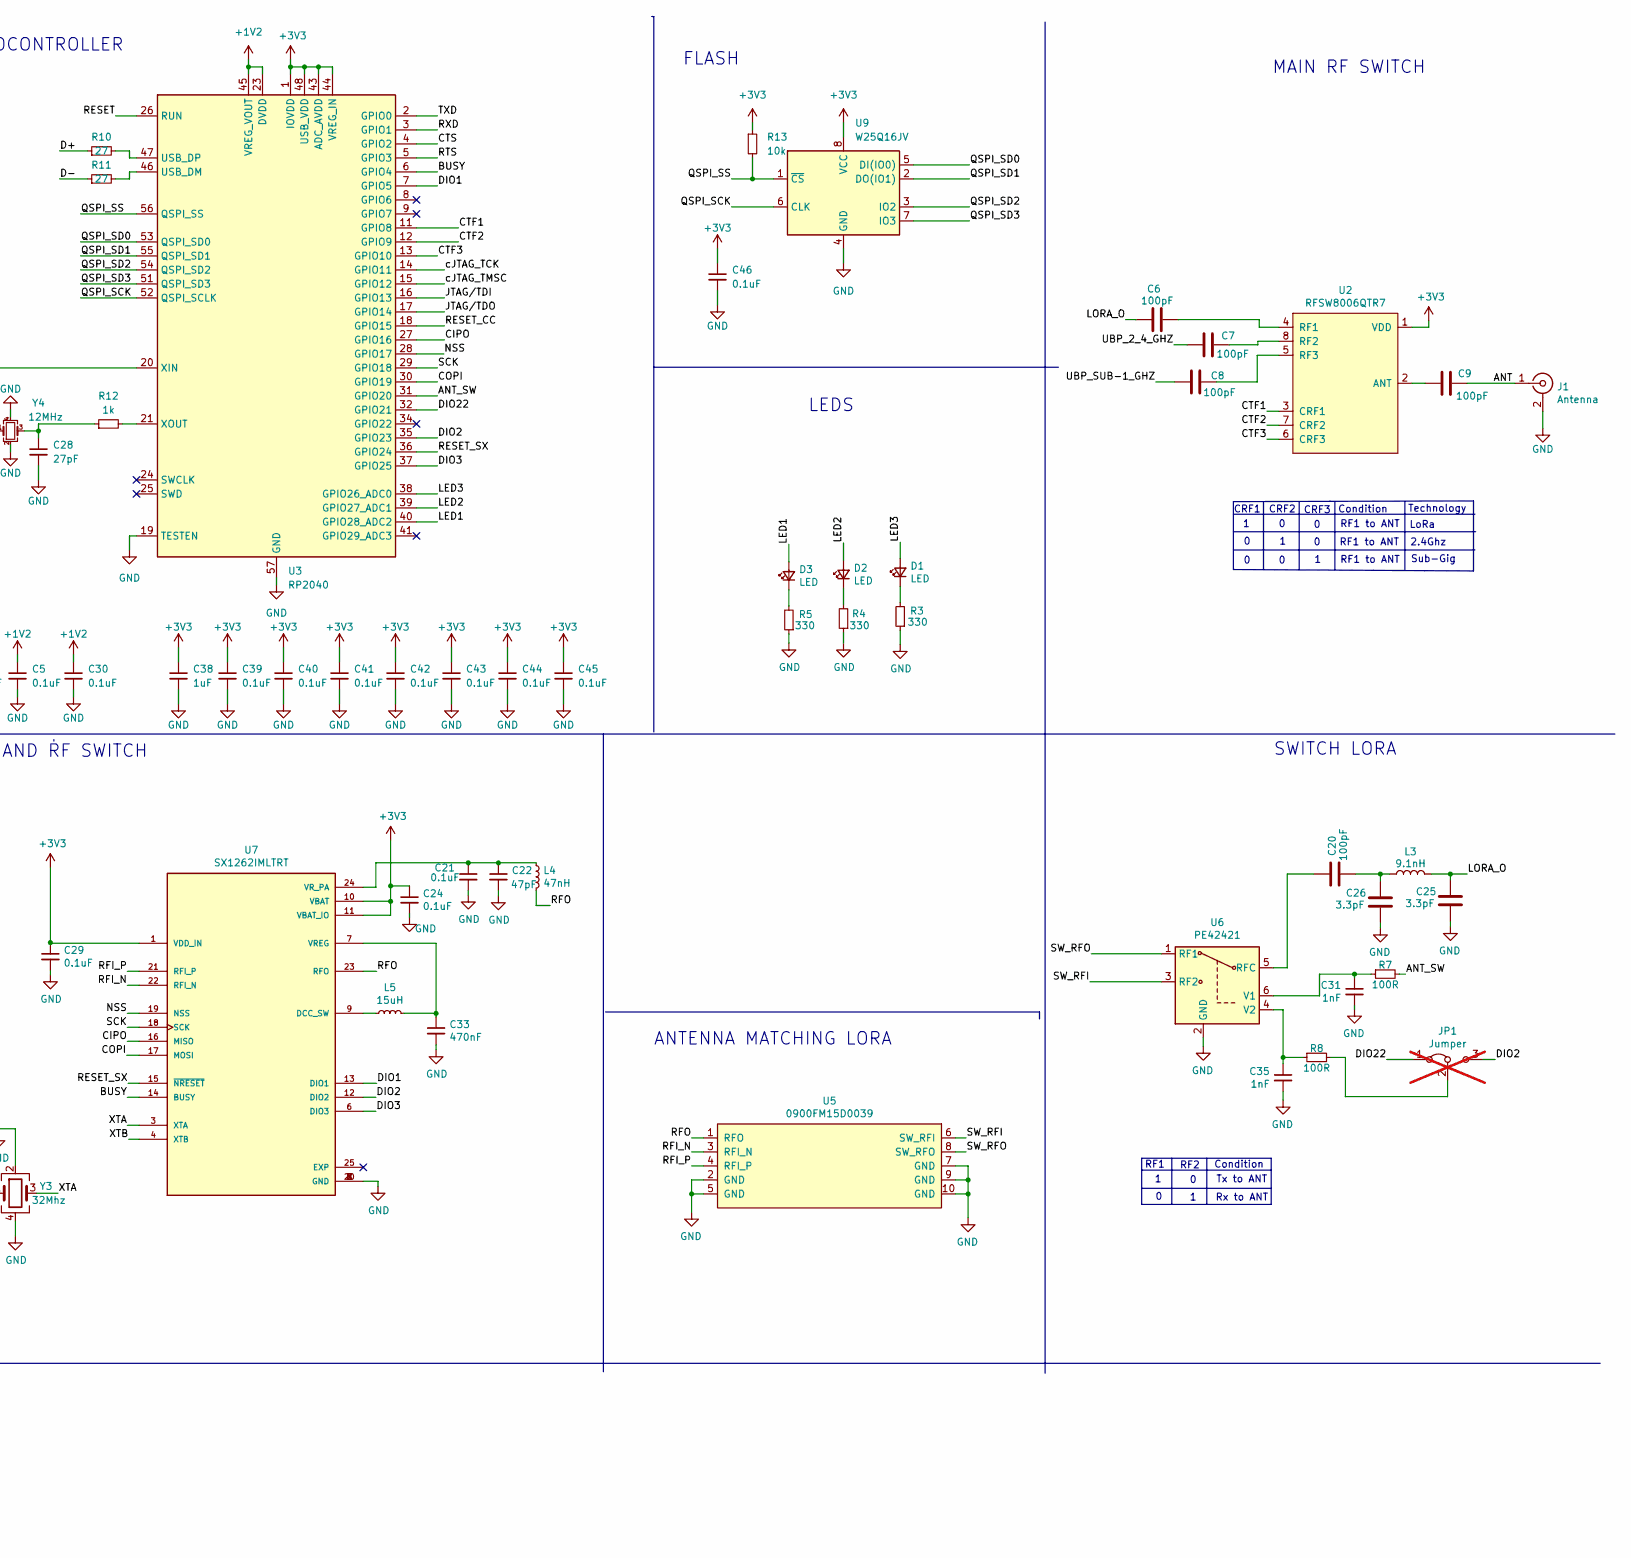
[picture p26: schematic CatSniffer.kicad_sch, part in row 1, column 2]

Parts:
BOOT1: SW; TS1088R02026; LCSC# C455281
C1, C37: 1uF; C_0603_1608Metric; LCSC# C108343
C2, C21, C24, C29: 0.1uF; C_0603_1608Metric; LCSC# C14663
C3, C38: 1uF; C_0402_1005Metric; Mouser# 963-MSRLJ103SB5105MF
C4, C28: 27pF; C_0402_1005Metric; Mouser# 81-GJM1555C1H270FB1D
C5, C30, C39, C40, C41, C42, C43, C44, C45, C46: 0.1uF; C_0402_1005Metric; Mouser# 963-MSAST105SB7104KF
C6, C7, C8, C9, C20, C23, C27: 100pF; C_0603_1608Metric; LCSC# C14858
C10, C11, C12, C13, C15, C16, C32: 100nF; C_0402_1005Metric; LCSC# C162179
C14, C17: 22uF; C_0603_1608Metric; LCSC# C109447
C18, C19: 22pF; C_0603_1608Metric; LCSC# C170132
C22: 47pF; C_0603_1608Metric; LCSC# C519486
C25, C26: 3.3pF; C_0603_1608Metric; LCSC# C162225
C31, C35: 1nF; C_0603_1608Metric; LCSC# C1588
C33: 470nF; C_0603_1608Metric; LCSC# C170149
C34, C36: 10pF; C_0603_1608Metric; LCSC# C472782
D1, D2, D3, D4: LED; LED_0603_1608Metric_Pad1.05x0.95mm_HandSolder; LCSC# C524045
F1: 0.5A; Fuse_0805_2012Metric_Pad1.15x1.40mm_HandSolder; Mouser# 594-MFU0805FF00500P1
J1: Antenna; SMA_EDGE; LCSC# C530661
J3: Conn_01x06_Female; Tag-Connect_TC2030-IDC-NL_2x03_P1.27mm_Vertical; not fitted
JP1: Jumper; SolderJumper-3_P1.3mm_Bridged12_RoundedPad1.0x1.5mm_NumberL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; not fitted
L1: BLM18HE152SN1D; L_0603_1608Metric; Mouser# BLM18HE152SN1D
L2: 6.8uH; L_0603_1608Metric; Mouser# MLZ1608M6R8WT000
L3: 9.1nH; L_0603_1608Metric; LCSC# C395094
L4: 47nH; L_0603_1608Metric; LCSC# C578001
L5: 15uH; L_0603_1608Metric; LCSC# C57838
P1: USB_C_Plug_USB2.0; C393939; LCSC# C709357
R1, R2: 5k1; R_0603_1608Metric; LCSC# C319561
R3, R4, R5, R9: 330; R_0603_1608Metric; LCSC# C408915
R6: 100K; R_0603_1608Metric; LCSC# C179820
R7, R8: 100R; R_0603_1608Metric; LCSC# C700506
R10, R11: 27; R_0402_1005Metric; Mouser# 755-ESR01MZPF27R0
R12: 1k; R_0402_1005Metric; Mouser# 594-MCS0402MD1001DE0
R13: 10k; R_0402_1005Metric; Mouser# 594-MCS04020D1002BE0
RESET1: SW; TS1088R02026; LCSC# C455281
RESET_CC1: SW; TS1088R02026; LCSC# C455281
SW1: SW; TS1088R02026; LCSC# C455281
U1: AP2112K-3.3; SOT-23-5; Mouser# 865-XC6210B332MR-G
U2: RFSW8006QTR7; SON50P200X200X90-9N; Mouser# 772-RFSW8006QTR7
U3: RP2040; QFN-56-1EP_7x7mm_P0.4mm_EP3.2x3.2mm; LCSC# C2040
U4: 0900PC15A0036; 0900FM15D0039E; Mouser# 609-0900PC15A0036E
U5: 0900FM15D0039; 0900FM15D0039E; Mouser# 609-0900FM15D0039E
U6: PE42421; SOT-363_SC-70-6; Mouser# 81-PE42421SCAA-Z
U7: SX1262IMLTRT; QFN-24-1EP_4x4mm_P0.5mm_EP2.65x2.65mm; Mouser# 947-SX1262IMLTRT
U8: CC1352P1F3RGZT; VQFN-48-1EP_7x7mm_P0.5mm_EP5.15x5.15mm_ThermalVias; Mouser# 595-CC1352P1F3RGZT
U9: W25Q16JV; W25Q16JVUUIQ; Mouser# 454-W25Q16JVUUIQTR
Y1: 48MHz; Crystal_SMD_3225-4Pin_3.2x2.5mm; LCSC# C389928
Y2: 32.768kHz; Crystal_SMD_2012-2Pin_2.0x1.2mm; LCSC# C97603
Y3: 32Mhz; Crystal_SMD_2520-4Pin_2.5x2.0mm; LCSC# C255969
Y4: 12MHz; Crystal_SMD_3225-4Pin_3.2x2.5mm; LCSC# C2848217

Connections:
+1V2: C3.1, C5.1, C30.1, U3.23 (DVDD), U3.45 (VREG_VOUT), U3.50 (DVDD)
+3V3: C2.2, C24.1, C29.1, C38.1, C39.1, C40.1, C41.1, C42.1, C43.1, C44.1, C45.1, C46.1, J3.1, L1.2, R13.1, U1.5 (VOUT), U2.1 (VDD), U3.1 (IOVDD), U3.10 (IOVDD), U3.22 (IOVDD), U3.33 (IOVDD), U3.42 (IOVDD), U3.43 (ADC_AVDD), U3.44 (VREG_IN), U3.48 (USB_VDD), U3.49 (IOVDD), U7.1 (VDD_IN), U7.10 (VBAT), U7.11 (VBAT_IO), U9.8 (VCC)
/2_4_GHZ_RF_N: U4.8 (BP_2_4_GHZ_RF_N), U8.2 (RF_N_2_4GHZ)
/2_4_GHZ_RF_P: U4.9 (BP_2_4_GHZ_RF_P), U8.1 (RF_P_2_4GHZ)
/ANT: C9.2, J1.1 (In)
/ANT_SW: R7.2, U3.31 (GPIO20)
/BOOT: BOOT1.2, U3.4 (GPIO2), U8.21 (DIO_15)
/BUSY: U3.6 (GPIO4), U7.14 (BUSY)
/CIPO: U3.27 (GPIO16), U7.16 (MISO)
/COPI: U3.30 (GPIO19), U7.17 (MOSI)
/CTF1: U2.3 (CRF1), U3.11 (GPIO8)
/CTF2: U2.7 (CRF2), U3.12 (GPIO9)
/CTF3: U2.6 (CRF3), U3.13 (GPIO10)
/D+: P1.A6 (D+), R10.1
/D-: P1.A7 (D-), R11.1
/DCDC_SW: L2.1, U8.33 (DCDC_SW)
/DIO1: U3.7 (GPIO5), U7.13 (DIO1)
/DIO2: JP1.3 (B), U3.35 (GPIO23), U7.12 (DIO2)
/DIO3: U3.37 (GPIO25), U7.6 (DIO3)
/DIO22: JP1.1 (A), U3.32 (GPIO21)
/JTAG/TDI: U3.16 (GPIO13), U8.26 (DIO_16)
/JTAG/TDO: U3.17 (GPIO14), U8.27 (DIO_17)
/LED1: D3.2 (A), U3.40 (GPIO28_ADC2)
/LED2: D2.2 (A), U3.39 (GPIO27_ADC1)
/LED3: D1.2 (A), U3.38 (GPIO26_ADC0)
/LED4: D4.2 (A), U8.37 (DIO_24)
/LORA_O: C6.1, C25.1, L3.1
/NSS: U3.28 (GPIO17), U7.19 (NSS)
/QSPI_SCK: U3.52 (QSPI_SCLK), U9.6 (CLK)
/QSPI_SD0: U3.53 (QSPI_SD0), U9.5 (DI(IO0))
/QSPI_SD1: U3.55 (QSPI_SD1), U9.2 (DO(IO1))
/QSPI_SD2: U3.54 (QSPI_SD2), U9.3 (IO2)
/QSPI_SD3: U3.51 (QSPI_SD3), U9.7 (IO3)
/QSPI_SS: R13.2, SW1.1, U3.56 (QSPI_SS), U9.1 (~CS)
/RESET: RESET1.1, U3.26 (RUN)
/RESET_CC: C32.1, J3.3, R6.1, RESET_CC1.2, U3.5 (GPIO3), U3.18 (GPIO15), U8.35 (~RESET_N)
/RESET_SX: U3.36 (GPIO24), U7.15 (~NRESET)
/RFI_N: U5.3 (RFI_N), U7.22 (RFI_N)
/RFI_P: U5.4 (RFI_P), U7.21 (RFI_P)
/RFO: L4.2, U5.1 (RFO), U7.23 (RFO)
/RXD: U3.3 (GPIO1), U8.19 (DIO_13)
/RX_TX: C27.2, U4.5 (RX_TX), U8.7 (RX_TX)
/SCK: U3.29 (GPIO18), U7.18 (SCK)
/SUB_1_GHZ_RF_N: U4.6 (BP_SUB1-_GHZ_RF_N), U8.4 (RF_N_SUB_1GHZ)
/SUB_1_GHZ_RF_P: U4.7 (BP_SUB1-_GHZ_RF_P), U8.3 (RF_P_SUB_1GHZ)
/SW_RFI: U5.6 (SW_RFI), U6.3 (RF2)
/SW_RFO: U5.8 (SW_RFO), U6.1 (RF1)
/TXD: U3.2 (GPIO0), U8.18 (DIO_12)
/UBP_2_4_GHZ: C7.1, U4.1 (UBP_2_4_GHZ)
/UBP_SUB-1_GHZ: C8.1, C23.1
/VDDR: C15.1, C16.1, C17.1, L2.2, U8.45 (VDDR), U8.48 (VDDR_RF)
/VDDS: C10.1, C11.1, C12.1, C13.1, C14.1, L1.1, R6.2, U8.13 (VDDS2), U8.22 (VDDS3), U8.34 (VDDS_DCDC), U8.44 (VDDS)
/X48M_N: C19.1, U8.46 (X48M_N), Y1.3
/X48M_P: C18.1, U8.47 (X48M_P), Y1.1
/XTA: U7.3 (XTA), Y3.3
/XTB: U7.4 (XTB), Y3.1
/cJTAG_TCK: J3.4, U3.14 (GPIO11), U8.25 (JTAG_TCKC)
/cJTAG_TMSC: J3.2, U3.15 (GPIO12), U8.24 (JTAG_TMSC)
GND: BOOT1.1, C1.1, C2.1, C3.2, C4.2, C5.2, C10.2, C11.2, C12.2, C13.2, C14.2, C15.2, C16.2, C17.2, C18.2, C19.2, C21.2, C22.2, C24.2, C25.2, C26.2, C27.1, C28.2, C29.2, C30.2, C31.2, C32.2, C33.2, C34.2, C35.2, C36.2, C37.2, C38.2, C39.2, C40.2, C41.2, C42.2, C43.2, C44.2, C45.2, C46.2, J1.2 (Ext), J3.5, P1.A1 (GND), P1.A12 (GND), P1.B1 (GND), P1.B12 (GND), P1.S1 (SHIELD), R1.1, R2.1, R3.1, R4.1, R5.1, R9.1, RESET1.2, RESET_CC1.1, SW1.2, U1.2 (GND), U3.19 (TESTEN), U3.57 (GND), U4.2 (GND), U4.3 (GND), U4.10 (GND), U5.2 (GND), U5.5 (GND), U5.7 (GND), U5.9 (GND), U5.10 (GND), U6.2 (GND), U7.2 (GND), U7.5 (GND), U7.8 (GND), U7.20 (GND), U8.49 (EGP), U8.49_1 (EGP), U8.49_2 (EGP), U8.49_3 (EGP), U8.49_4 (EGP), U8.49_5 (EGP), U8.49_6 (EGP), U8.49_7 (EGP), U8.49_8 (EGP), U8.49_9 (EGP), U8.49_10 (EGP), U8.49_11 (EGP), U8.49_12 (EGP), U8.49_13 (EGP), U8.49_14 (EGP), U8.49_15 (EGP), U8.49_16 (EGP), U8.49_17 (EGP), U8.49_18 (EGP), U8.49_19 (EGP), U8.49_20 (EGP), U8.49_21 (EGP), U9.4 (GND), Y1.2, Y1.4, Y3.2, Y3.4, Y4.2, Y4.4
unnamed: C20.2, C26.1, L3.2
unnamed: C28.1, R12.1, Y4.3
unnamed: D1.1 (K), R3.2
unnamed: D2.1 (K), R4.2
unnamed: D3.1 (K), R5.2
unnamed: D4.1 (K), R9.2
unnamed: F1.1, P1.A4 (VBUS), P1.A9 (VBUS), P1.B4 (VBUS), P1.B9 (VBUS)
unnamed: JP1.2 (C), R8.2
unnamed: P1.A5 (CC), R1.2
unnamed: P1.B5 (VCONN), R2.2
unnamed: C9.1, U2.2 (ANT)
unnamed: C6.2, U2.4 (RF1)
unnamed: C7.2, U2.8 (RF2)
unnamed: C8.2, U2.5 (RF3)
unnamed: R11.2, U3.46 (USB_DM)
unnamed: R10.2, U3.47 (USB_DP)
unnamed: C4.1, U3.20 (XIN), Y4.1
unnamed: R12.2, U3.21 (XOUT)
unnamed: C23.2, U4.4 (UBP_SUB-1_GHZ)
unnamed: C20.1, U6.5 (RFC)
unnamed: C31.1, R7.1, U6.6 (V1)
unnamed: C35.1, R8.1, U6.4 (V2)
unnamed: L5.1, U7.9 (DCC_SW)
unnamed: C33.1, L5.2, U7.7 (VREG)
unnamed: C21.1, C22.1, L4.1, U7.24 (VR_PA)
unnamed: C37.1, U8.23 (DCOUPL)
unnamed: C34.1, U8.8 (X32K_Q1), Y2.1
unnamed: C36.1, U8.9 (X32K_Q2), Y2.2
VCC: C1.2, F1.2, U1.1 (VIN), U1.3 (EN)

Notes on the sheet:
RF1 to ANT
cJTAG - Matching CC1350
Rx to ANT
Pin 48
Pin 33
2.4Ghz
CRF2
REGULATOR AND BATTERY
ANTENNA MATCHING LORA
RF1
SWITCH LORA
ANTENNA MATCHING 2.4 AND 1 GHZ
Pin 34
Pin 45
CRF1
FILTERING VOLTAGE
Condition
Pin 44
Technology
FLASH
Pin 22
Tx to ANT
MAIN RF SWITCH
BUTTONS
Pin 13
CC1352
LoRa
CRF3
Sub-Gig
MICROCONTROLLER
USB
SX1262 AND RF SWITCH
LEDS
RF2

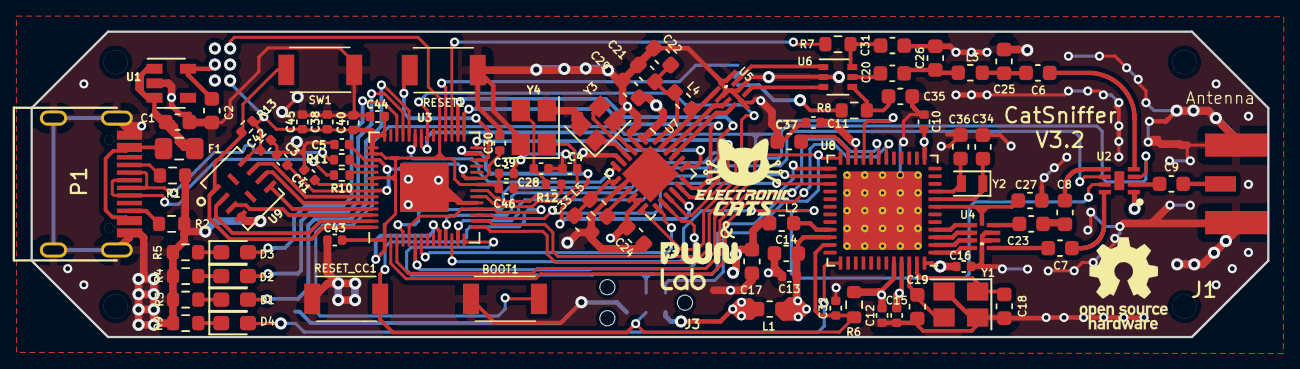
[picture p27: board CatSniffer.kicad_pcb from above]

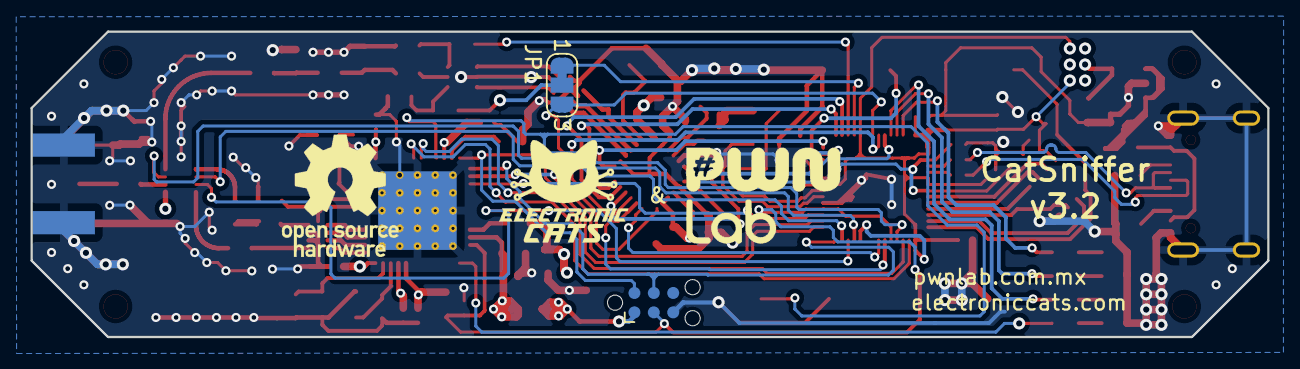
[picture p28: board CatSniffer.kicad_pcb from below]

Board: 4 copper layers, 81.0 x 20.0 mm, 90 parts (2 on the bottom side), 88 nets.
