ElectronicCats/CatSniffer/workshops/BH Asia 2024 Arsenal Lab - Catsniffer/Files/pycatsniffer_bv3/Modules/Utils.py

import os
import time
import platform
import re
import uuid


def validate_access_address(access_address):
    regex = re.compile(r"^(?:[0-9a-fA-F]{2}:){5}[0-9a-fA-F]{2}$|^[0-9a-fA-F]{12}$")
    return bool(regex.match(access_address))


def clear_screen():
    """Function to clear the screen."""
    if platform.system() == "Windows":
        os.system("cls")
    else:
        os.system("clear")


def create_folders(path):
    """Function to create folders."""
    if not os.path.exists(path):
        os.makedirs(path)


def generate_filename():
    """Function to generate a filename."""
    return time.strftime("%Y%m%d%H%M%S") + "_" + str(uuid.uuid4())[:8]



def LOG_INFO(message):
    """Function to log information."""
    print(f"[INFO] {message}")

def LOG_ERROR(message):
    """Function to log error."""
    print(f"\x1b[31;1m[ERROR] {message}\x1b[0m")

def LOG_WARNING(message):
    """Function to log warning."""
    print(f"\x1b[33;1m[WARNING] {message}\x1b[0m")
