ElectronicCats/CatSniffer/(commit log)

2020-08-15 init schematic
    [CatStick.kicad_pcb, CatStick.sch]
2020-08-15 schematic basic for cc1352
    [CatStick.sch]
2020-08-15 added Antenna Matching beta
    [CatStick.sch]
2020-08-15 added switching RF
    [CatStick.sch]
2020-08-15 Vcc USB
    [CatStick.sch]
2020-08-15 init schematic for SAMR34
    [CatStick.sch]
2020-08-16 change labels
    [CatStick.sch]
2020-12-08 add cache lib
    [CatStick.sch]
2021-01-24 update labels
    [CatStick.sch]
2021-04-12 Change to SAMD21E and SX1262 LoRa
    [CatStick.sch]
2021-04-21 switch RF
    [CatStick.sch]
2021-04-27 Modify schematic for better reading
    [CatStick.sch]
2021-04-27 add line
    [CatStick.sch]
2021-05-03 fix source for cc1352
    [CatStick.sch]
2021-05-04 update floorplan
    [CatStick.kicad_pcb]
2021-05-04 add 3D
    [CatStick.kicad_pcb]
2021-05-07 updated floorplan
    [CatStick.kicad_pcb, CatStick.sch]
2021-05-11 udate traces and sch to best routes
    [CatStick.kicad_pcb, CatStick.sch]
2021-05-11 update trace
    [CatStick.kicad_pcb]
2021-05-16 update RF with correct impedance
    [CatStick.kicad_pcb]
2021-05-16 update impedance information
    [CatStick.kicad_pcb]
2021-05-17 update RF traces
    [CatStick.kicad_pcb, CatStick.sch]
2021-06-11 update info RF switch
    [CatStick.sch]
2021-06-14 add logos
    [CatStick.kicad_pcb]
2021-06-18 fix ground planes
    [CatStick.kicad_pcb]
2021-06-21 add groudn connection
    [CatStick.kicad_pcb, CatStick.sch]
2021-07-02 DRC clean
    [CatStick.kicad_pcb]
2021-07-08 update traces RX/TX
    [CatStick.kicad_pcb]
2021-07-09 v1.2 production
    [CatStick.kicad_pcb]
2021-07-19 rename project kicad
    [CatSniffer.kicad_pcb, CatSniffer.sch]
2021-08-02 Screenshots para documentacion en espanol
2021-08-02 EM Analysis in the IoT Context: Lessons Learned from an Attack on Thread
2021-08-02 Agrega informacion del switch
2021-08-02 Corrige version de SmartRF Packet Sniffer
2021-08-04 add submodule thread cc1352
2021-08-17 Basic case for CatSniffer
    [CatSniffer-case-bottom.stl, CatSniffer-case-top-flat.stl, CatSniffer-case-top.stl, CatSniffer-case.step]
2021-08-21 Moves firmware to fw folder
    [sniffle.cfg]
2021-08-21 Adds info about switch
2021-08-26 case mamalon v1
    [sc_case.stl, sc_top.stl]
2021-08-26 basic case in folder
    [CatSniffer-case-bottom.stl, CatSniffer-case-top-flat.stl, CatSniffer-case-top.stl, CatSniffer-case.step]
2021-09-11 Removes sniffle as files
    [sniffle.cfg]
2021-09-13 Cambios de readme
2021-09-13 Adds image with buttons reference
2022-03-23 erase extra files
    [CC1352P1F3RGZT.step, CatSniffer.sch]
2022-05-04 update version
    [CatSniffer.kicad_pcb, CatSniffer.kicad_sch]
2022-08-08 Update label 2.0
    [CatSniffer.kicad_pcb]
2023-01-02 receive threading running
2023-01-02 extract frames
2023-01-11 RFSW8006QTR7 change footprint
    [CatSniffer.kicad_pcb, CatSniffer.kicad_sch]
2023-01-19 update rp2040
    [CatSniffer.kicad_pcb, CatSniffer.kicad_sch]
2023-02-14 fix BOM and add 3d components
    [CatSniffer.kicad_pcb, CatSniffer.kicad_sch]
2023-04-03 fix serigraphy
    [CatSniffer.kicad_pcb]
2023-04-03 fix serigraphy "c14"
    [CatSniffer.kicad_pcb]
2023-04-22 add pico firmware
2023-05-22 fix SPI RF port
    [CatSniffer.kicad_sch]
2023-05-22 Routed CIPO, NSS, SCK, COPI, CTF1 and CTF2
    [CatSniffer.kicad_pcb]
2023-05-31 add components replacements and fix "antena" serigraphy
    [CatSniffer.kicad_pcb, CatSniffer.kicad_sch]
2023-06-06 add serigraphy version to "V3.1"
    [CatSniffer.kicad_pcb]
2023-06-23 update RF switch connected to microcontroller
    [CatSniffer.kicad_pcb, CatSniffer.kicad_sch]
2023-06-23 fix serigraphy version v3.2 to v3.1
    [CatSniffer.kicad_pcb]
2023-06-23 edit footprint of U5 & U4 for better view of polarity
    [CatSniffer.kicad_pcb]
2023-07-11 add LED animation for upload
2023-11-22 fix lower case hex input, fix set_tx_ascii()
2023-11-22 fix lower set tx ascii samd21
    [LoRaCatSniffer.ino]
2023-12-20 Update README.md
    Ahora si ya estan todas las imagenes en GitHub. Se agregaró la imagen de la versión 3 de la tarjeta, la imagen con liga a la tienda y la imagen con liga a la wiki. También modifique los protocolos y los softwares compatibles para reflejar los que soporta la v3.
2024-01-18 Enlarged U4, U5 and update PCB
    [CatSniffer.kicad_pcb]
2024-01-21 remove all software related
    [CatSniffer-case-bottom.stl, CatSniffer-case-top-flat.stl, CatSniffer-case-top.stl, CatSniffer-case.step, sc_case.stl, sc_top.stl]
2024-04-24 feat(docs):Update README.md
    Add distributor store button
2024-06-25 Agrega case con leyenda 'Catsniffer'
    [Case-CatSniferText.3mf]
2024-09-05 feat(Hw): Update labels
    [CatSniffer.kicad_pcb]
2025-08-16 Create Catsniffer-Setup-and-Firmware-Strategy.ipynb
    Agrega el primer notebook que demuestra como cargar y probar un firmware.
2026-10-12 docs: distributors button in the same style as the store and wiki buttons
2026-10-12 docs: distributors button with the same rounded typeface as the other buttons
2026-10-12 docs: a heading above the button row so the images read as links
